mfolejewski/MirkoPC/readme.txt

Modular Integrated Raspberry Pi Computer
Yet another carrier board for Raspberry Pi Compute Module 4
