mfolejewski/MirkoPC/3D_ENCLOSURE/readme.txt

dedicated 3D printed case for MirkoPC REV1.1
