mfolejewski/MirkoPC/drawings/MirkoPC_bot_user.png

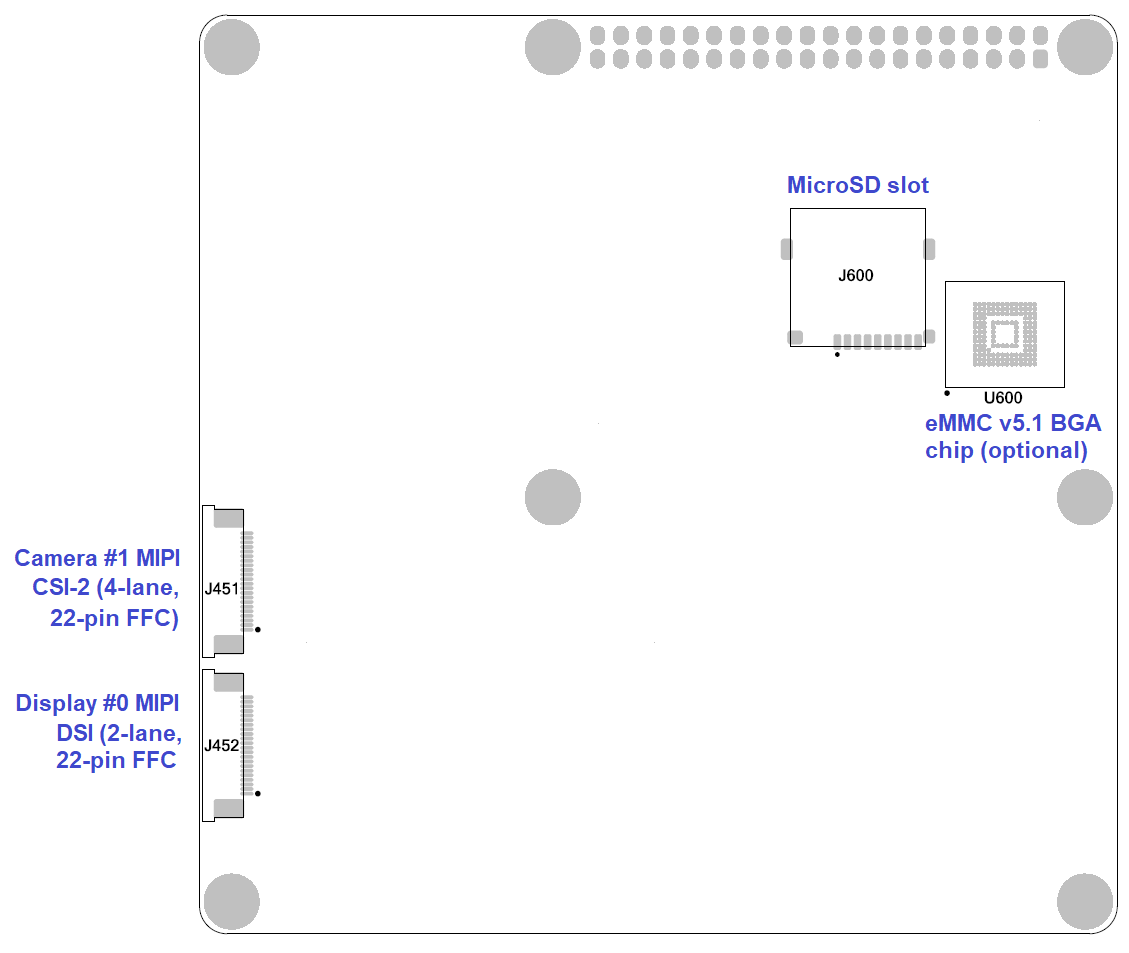
drawings/MirkoPC_bot_user.png
