mfolejewski/MirkoPC/drawings/MirkoPC_mechanical_drawing.png

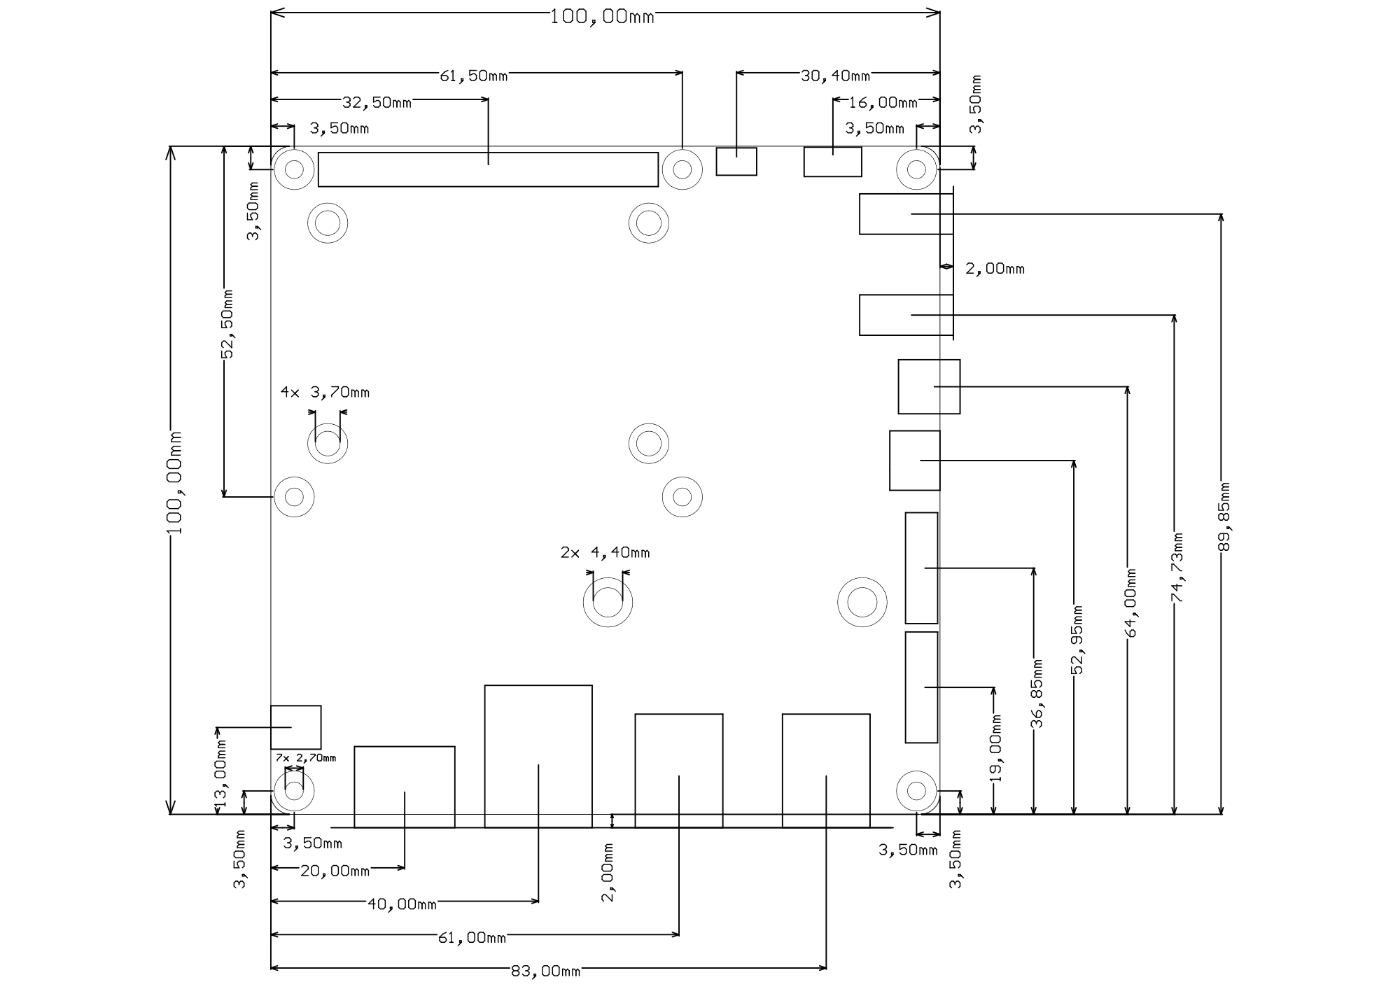
drawings/MirkoPC_mechanical_drawing.png
