mfolejewski/MirkoPC/drawings/MirkoPC_top_user.png

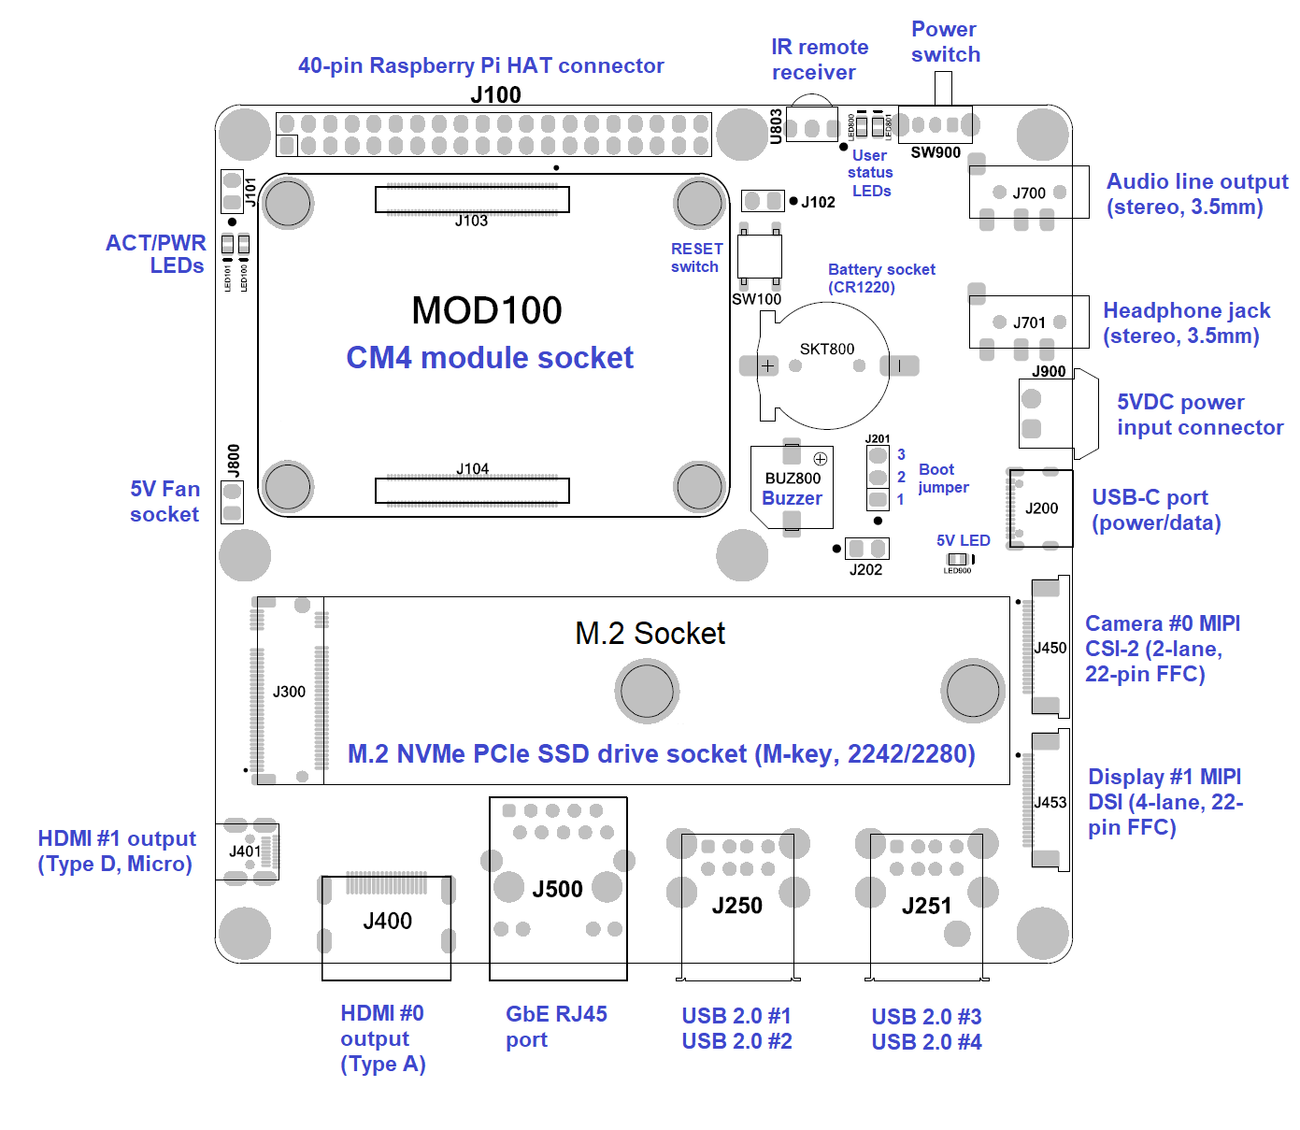
drawings/MirkoPC_top_user.png
