mfolejewski/MirkoPC/drawings/MirkoPC_bot_component.png

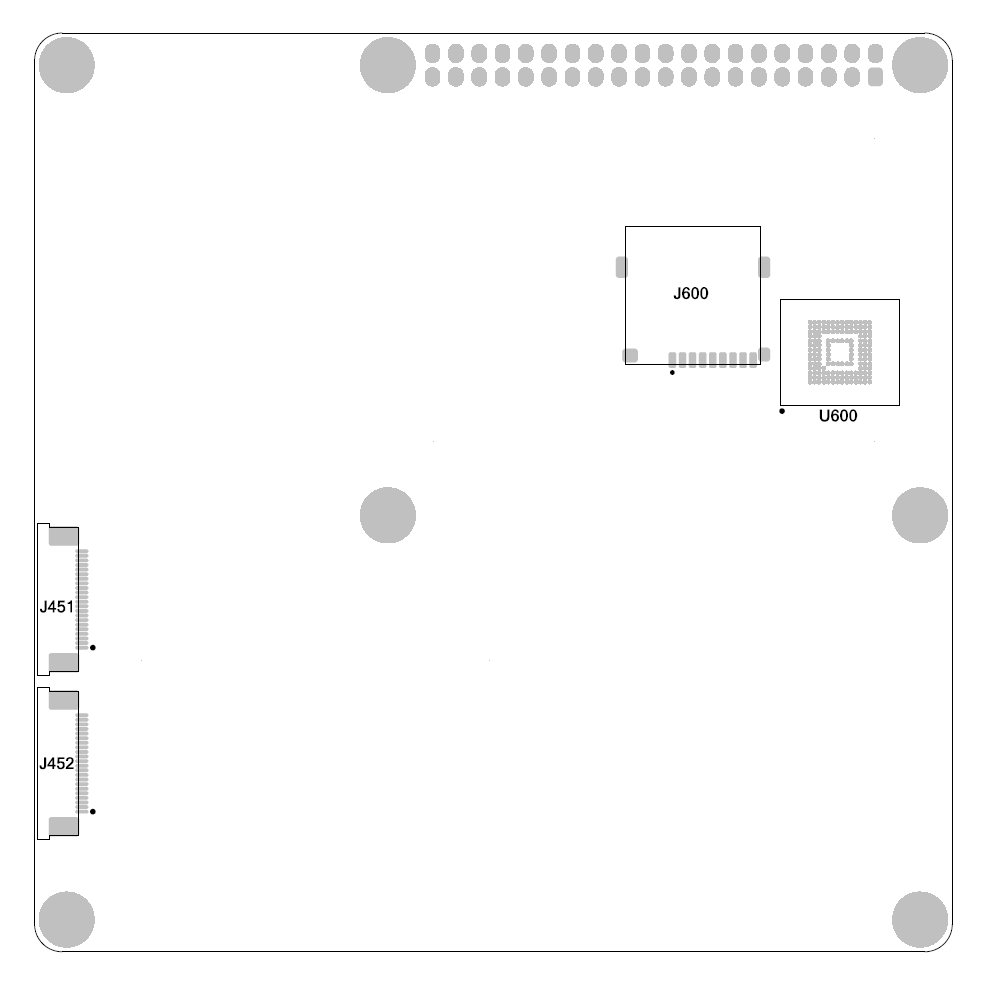
drawings/MirkoPC_bot_component.png
