mfolejewski/MirkoPC/drawings/MirkoPC_top_component.png

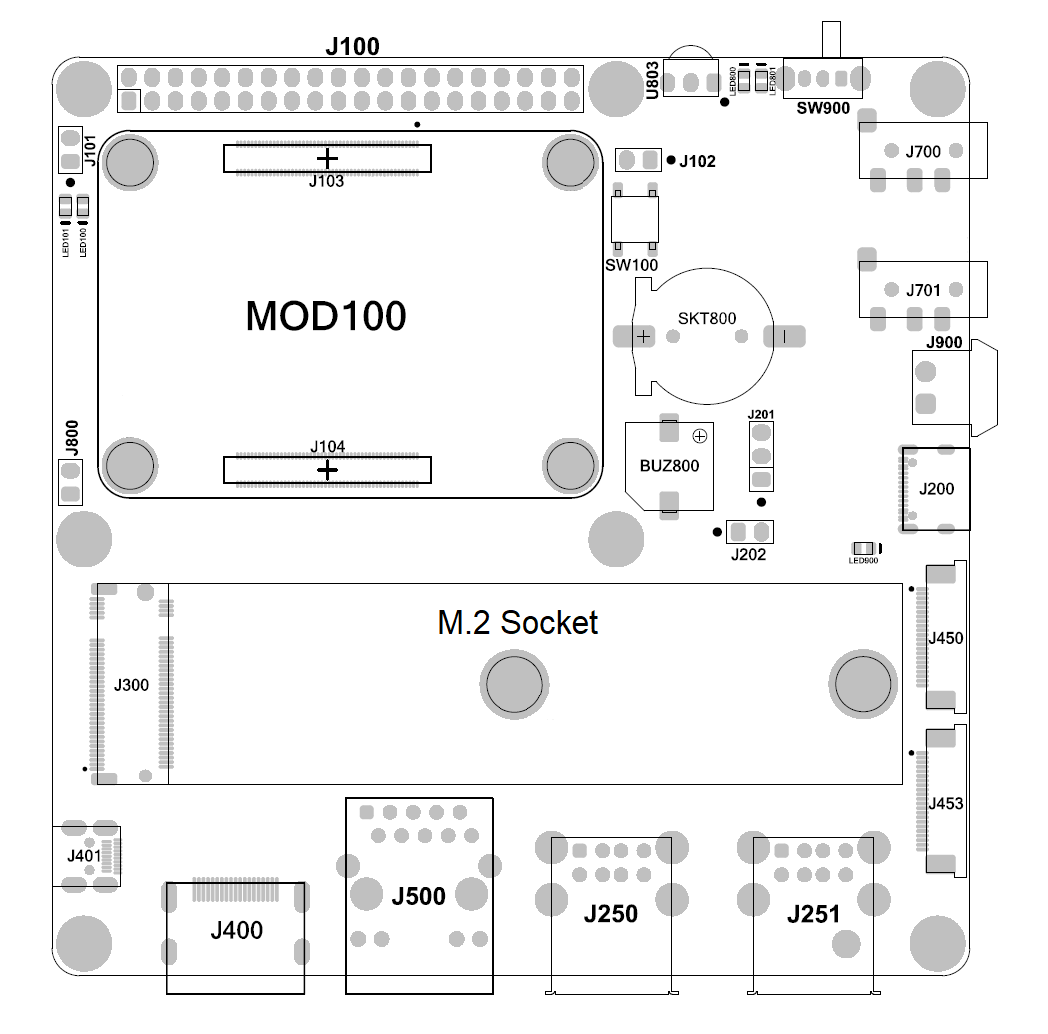
drawings/MirkoPC_top_component.png
