mfolejewski/MirkoPC/3D_ENCLOSURE/MirkoPC REV1.1 3D CASE (BOT).STL

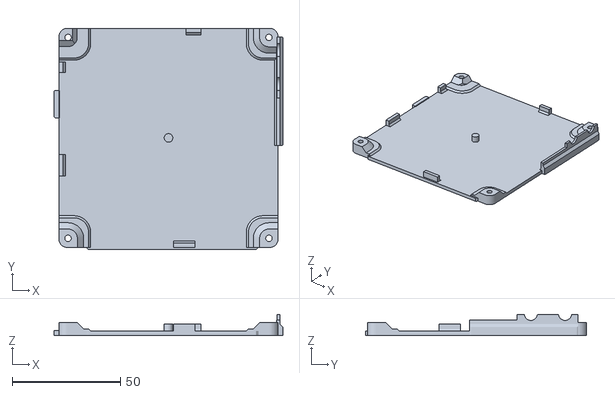
[picture p6: CAD file, 2021-11-18]
3D_ENCLOSURE/MirkoPC REV1.1 3D CASE (BOT).STL
106.0 x 102.5 x 9.75
