mfolejewski/MirkoPC/MirkoPC_REV1_Mechanical_dimensions_20210407.DXF

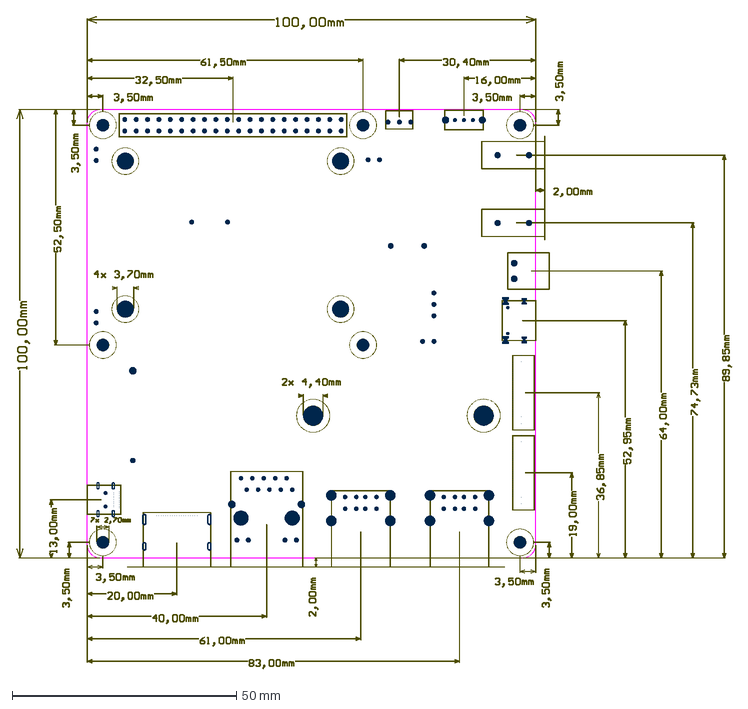
[picture p7: CAD file, 2021-04-07]
MirkoPC_REV1_Mechanical_dimensions_20210407.DXF
159.4 x 145.4 mm
