mfolejewski/MirkoPC/3D_ENCLOSURE/MirkoPC REV1.1 3D CASE (TOP).STL

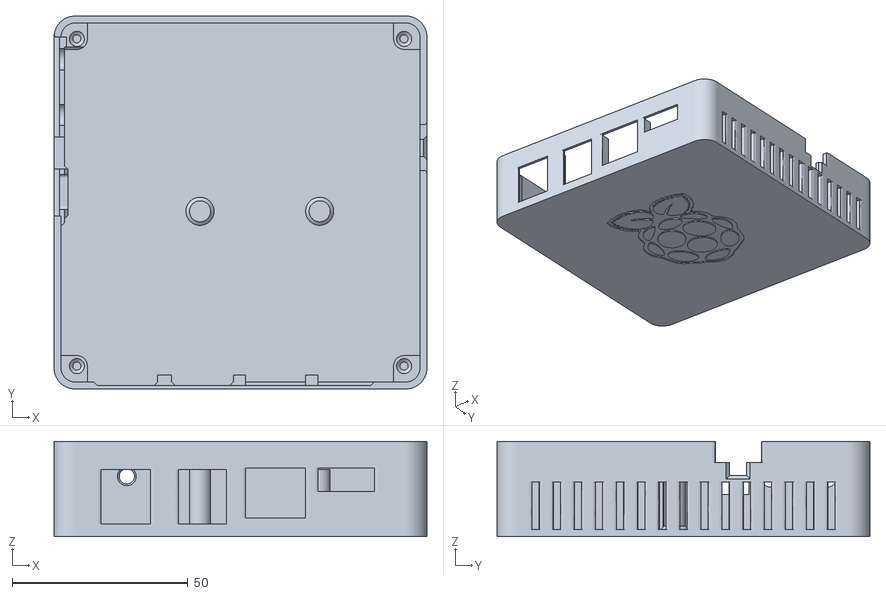
[picture p8: CAD file, 2021-11-18]
3D_ENCLOSURE/MirkoPC REV1.1 3D CASE (TOP).STL
106.0 x 106.0 x 27.0
