mfolejewski/MirkoPC/MirkoPC_V1_dimensions_2021-03-16.dxf

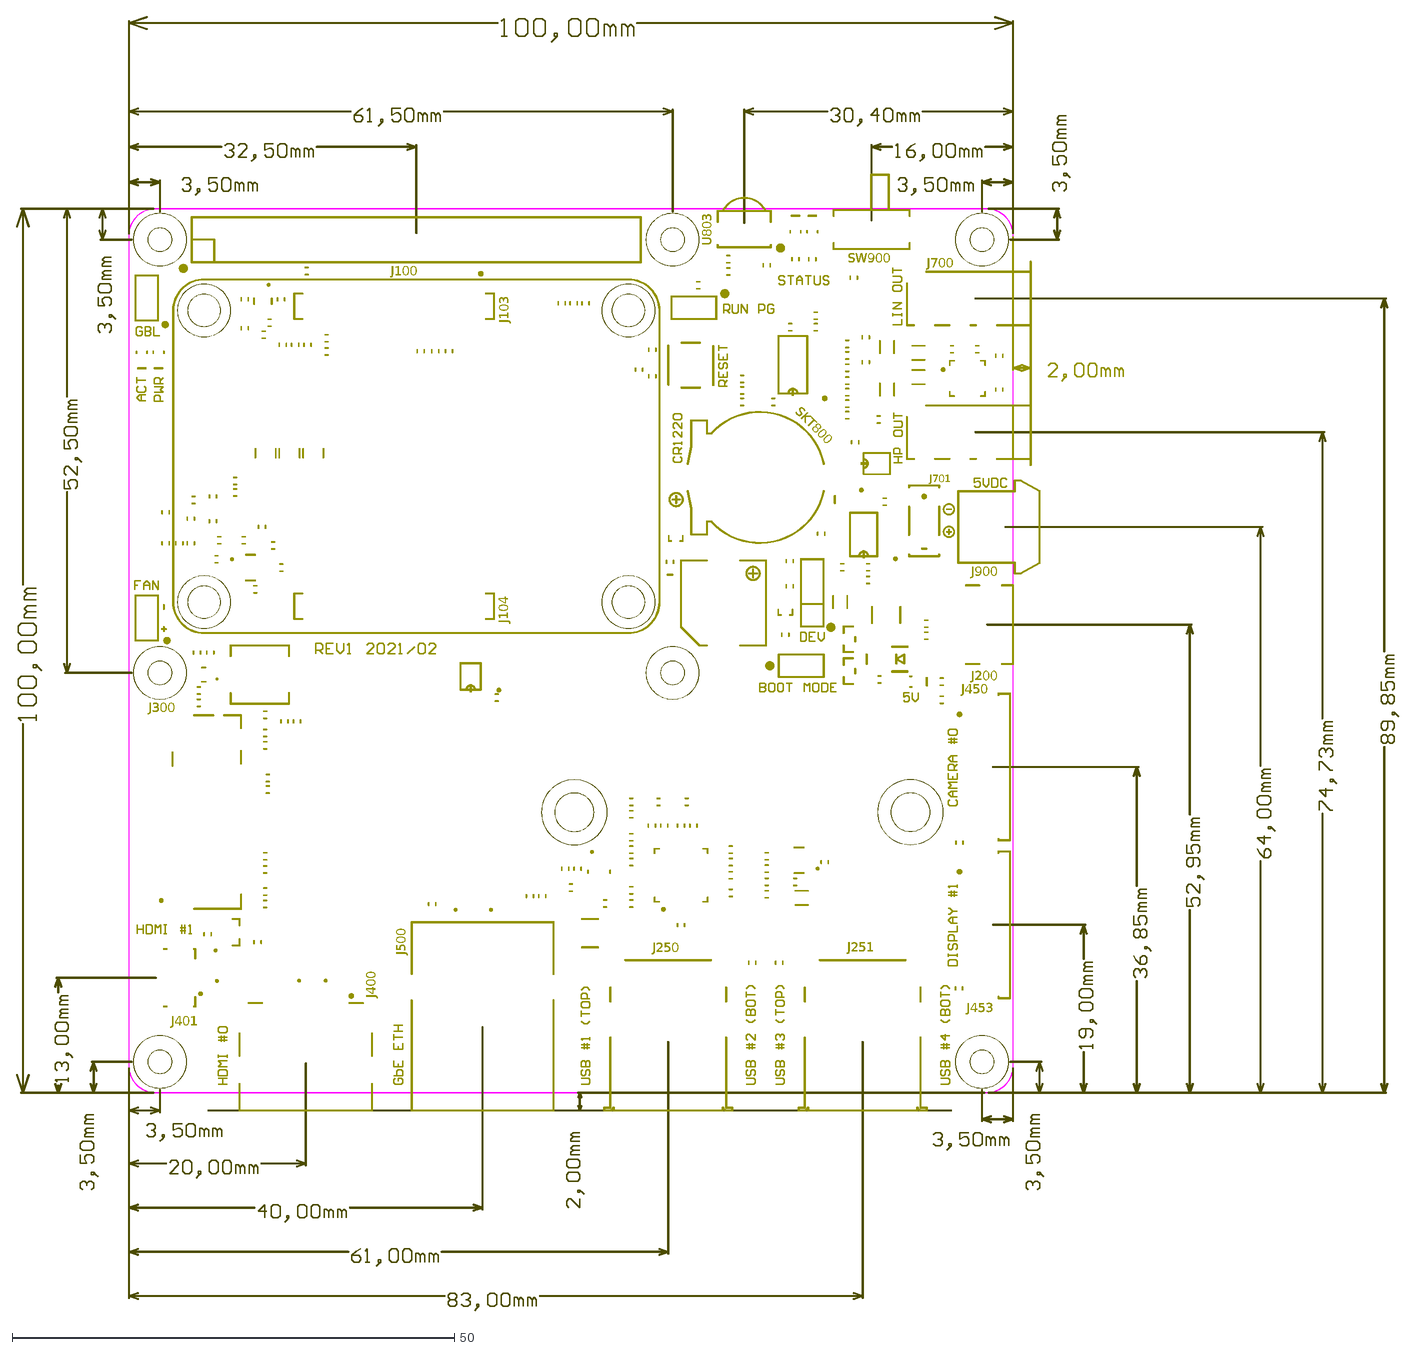
[picture p9: CAD file, 2021-03-16]
MirkoPC_V1_dimensions_2021-03-16.dxf
J701
J700
J104
J103
J100
J200
SW900
SKT800
U803
J453
J450
J400
J401
J300
J500
J250
J251
J900
