mfolejewski/MirkoPC/RPI_MiniPC_V1R1_Beta_Dimensions_20210206.DXF

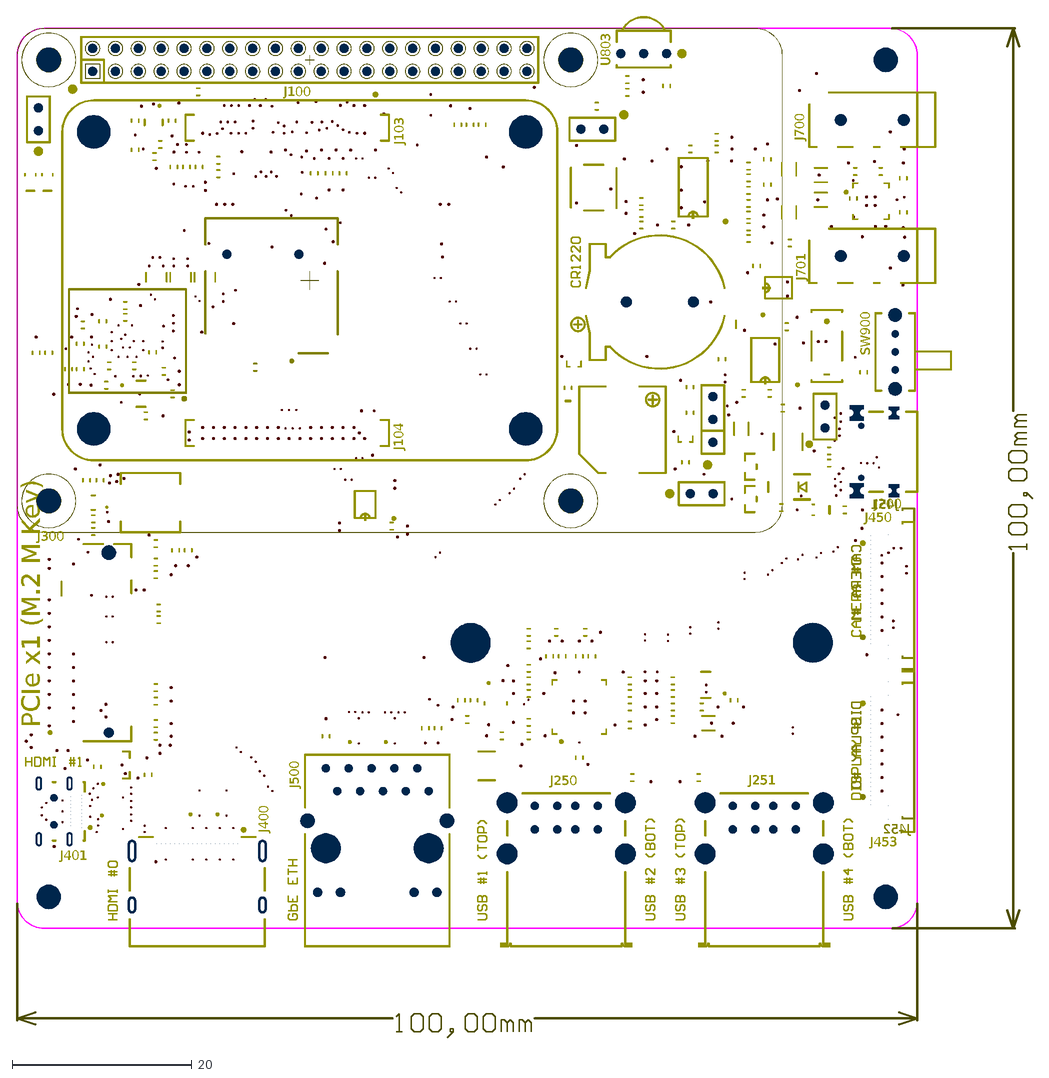
[picture p10: CAD file, 2021-02-06]
RPI_MiniPC_V1R1_Beta_Dimensions_20210206.DXF
PCIe x1 (M.2 M Key)
J701
J700
J104
J103
J100
J200
SW900
U803
J453
J452
J451
J450
J400
J401
J300
J500
J250
J251
