mfolejewski/MirkoPC/user_manual/readme.txt

Official user manual (datasheet) for MirkoPC users
