mfolejewski/MirkoPC/(threads)

Thread 1 (2021-04-07):

Publish news & updates here?

mi-hol, 2021-04-07:
The are folks that don't use Twitter/Facebook/... for good reasons.
Would it be feasible to publish news & updates in the future here too?

mfolejewski, 2021-04-07:
to tell you the truth, I don't know how to post updates on github, I use it very rarely .
So far, I'm using only Twitter or hackaday.io to publish project update.

mi-hol, 2021-04-13:
I noticed that updates via twitter had not been made on hackaday.io

hackaday.io would be a great source for the community.

Many project use github as the master for every communication, because it allows for simple migration of content to new distribution channels.
examples:
[](https://github.com/geerlingguy/raspberry-pi-pcie-devices/issues/112)

mfolejewski, 2021-04-14:
Yes you have right, on hackaday.io there is less data.
For me is easiest to create new post on Twitter (much faster).

Is really hard to publish news by using 3 different channels (github, hackaday and Twitter), due to I'm not full time maker as Jeff (sorry about that, but I don't have not enough time in my free time).

I'm using github to publish only the technical files.

Soon this project will be closed and I will switch to the next (I hope).

Thread 2 (2021-04-10):

MirkoPC_V1_3D_model_2021-03-16.pdf damaged/wrong content?

TMillesich, 2021-04-10:
The file:
MirkoPC_V1_3D_model_2021-03-16.pdf 11MB

shows only a white rectangle.
Even at 1000% no further details visible.

PDF Informations:
Paper Dimension: 2,97 x 2,09 cm

mfolejewski, 2021-04-11:
Github issue.
Please download this file and use Adobe Acrobat to open it.

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

mfolejewski, 2021-04-14:
I checked the PDF file on the github, is OK.
If you have an issue opening this file -> just download this PDF file and use free Adobe Acrobat Viewer.
Another option - please download the STEP 3D file and use any 3D CAD tool, e.g. FreeCAD, Inventor, Fusion 360.

Closed 2021-04-14.

Thread 3 (2021-04-18):

plase  think about 802.3at ;)

lsochanowski, 2021-04-18:
it will resolve 15W power problem and it will be best board in the world ;)

mfolejewski, 2021-04-20:
Thanks!

1. "15W issue"
OK, I need to clarify "15W issue". I added the 3A polymer fuse, to limit the input power due to USB-C spec. Unfortunately, it turned out that this fuse has too high series resistance and during operation it causes voltage drops on the 5V bus, approx. 0.1V, which causes irritating messages. My fault. Apart from the voltage drop, nothing bad is happening. The CM4 has its own PMIC which generates 3.3V and 1.8V voltages for the CPU, eMMC and RAM. The M.2 slot has its own 3A buck regulator. The rest of the hardware is powered by 3.3V from the PMIC CM4. Only the USB ports are powered from the 5V bus - however, the voltage drop to 4.8V has no negative consequences. The USB electronics have their own LDO or converters anyway, so apart from the annoying message, nothing bad is happening. I tested NVMe + CPU @ 2.2GHz, it worked stably.
I bridged the fuse in all other boards.
In REV1.1, the fuse will be removed because it causes more problems than benefits.
Unfortunately, powering electronics from 5V causes some problems, but it also has many advantages -> you can power the board from the USB-C port, mobile chargers or original RPi power supplies. As simple DIY project 5V rail is quite OK.

2. NVMe power consumption
Another thing - the power consumption of the NVMe disk. Since CM4 has only x1 lane and only GEN2, therefore drives specified even as 3V3 @ 3A will not consume such current (probably somewhere 50% less), due to the low PCIe bandwidth of approx. Max. 360MB / s (approx. 8-10x less than the max. throughput of NVMe disks - I'm guessing).

3. PoE support
I thought about adding the PoE option, but it would involve replacing the RJ45 connector with a more expensive one (I don't know if the footprint will be compatible) and there may also be a problem with adding the connectors (possible collision with the M.2 card).

Unfortunately, since the RJ45 connector is in a different location than on the RPi 4B, the PoE option would not be compatible with the original HATs.

The only chance is to add a 4-pin connector pointing down the board, but this would also require the design of a dedicated PoE + power supply, then it makes sense to design an industrial 12 / 24V power supply.

Initially, I had a plan to expand the project (hence the name: Modular Integrated Computer) and add at least 3 boards:
- IOB (input / outputs, analog / digital),
- GSB (GbE switch, 4xRJ45, 1 / 2x SFP sockets),
- IOT (RF - GSM / GNSS / LoRa / etc.),
- PSU (dedicated industrial power supply, 9-36V, 18-72V) + PoE option,
Unfortunately, such a project would require a lot of $$$ (serious investor required). This is an DIY project for now.

Anyway, I will consider the option of adding PoE and outputting the 5V / 3.3V system bus -> just in case and for future use -> but only for the REV2 (now I'm working on the REV1.1 to fix all the minor issues).

Thread 4 (2021-04-20):

co jest potrzebne

ojej, 2021-04-20:
Myśle, że to jest szansa na zrobienie sprzętu, którego nie ma.
Komputery maja problemy z zasilaniem. Nie ma komputera dla ludzi, którzy wola terminal, ale chca by sprzęt działał tydzien na jednym ładowaniu lub miesiąc. Nie musi być szybki ale zasilanie jest kluczem.
Trend jest taki, że wiele osób chce wrecz komputer do pisania jak zx88 https://en.wikipedia.org/wiki/Cambridge_Z88 albo https://www.clockworkpi.com/devterm albo https://hackaday.io/project/9692-ello-2m

Coś co ma normalny system ale jednocześnie jest mobilne. Nie działa przez 2 godziny, ale jest na prawde mobilne. jak psion 5 https://jm.iq.pl/psion-5mx-z-linuxem-na-pokladzie/ który działa tydzien na 2 paluszkach (choc ma 16Mhz zegar). Kluczem jest zasilanie i wygodna klawiatura. (choćby taka https://klawiatura.wordpress.com/wersja-mini/ tzw. czekolada gdzie masz 2 rodzaje klawiszy ułozonych normalnie a nie jak w mechanicznych klawiaturach)

Każdy kto próbował pisac na klawiaturze choć trochę szybciej wie, że tekst komputerowy z ;"|}{<>., itd nie jest możliwe pisanie szybko na klawiaturze laptopowej. Bo potrzebna jest normalna.

Zastanów się sam. Gdybyś miał mało prądu, był np. w podróży bez gniazdka, była wojna, to czy bys chciał komputer, którym możesz wysłac e-mail? Aby to zrobić malina nawet zero jest za duża. A jednocześnie jest niesamowicie wygodna. Ale nie dasz rodzinie sprzętu z mnóstwem kabli, z powerbankiem i powiesz, ze bedzie działać tylko 2 minuty. Dlatego warto stworzyć sprzęt niewielki, który można nosic ze sobą, ale który jest kompletny do małych zastosowań. Zasilanie jest głównym problemem. Którego wiekszość osób w ogóle nie bierze pod uwagę.

Panele słoneczne sa rewelacyjne, o ile ich nie musisz nosic i ne plącza się kable. Pisanie rysikiem nie jest złe gdy nie musisz pisac listu w slabym oswietleniu. Zatem klawiatura, solidna i wygodna, zasilanie i niewielki ekran jako awaryjne czytanie i pisanie. Wszystko zintegrowane (zapewne mechaniczne klawisze) w pojedyńczej obudowie. Bez zbędnego rozpraszania, bez komunikatorów, www itp.

Jeśli jestes programistą, pisarzem lub po prostu coś toworzysz a nie tracisz czas przy komputerze docenisz komputer, który nie rozładuje sie w ciągu jazdy pociągiem i wystarczy na tyle by napisac opowiadanie.

Pomyśl nad tym i zapytaj innych ludzi czy taki sprzet jest dla nich wazny. Czy nie czują się uwiązania do gniazdka, cywilizacji. Ja chciałbym cos małego co ma normalną klawiature jak ta na której piszę, terminal, ssh, mutt, gcc, ruby, python, mc, git. A jeśli trzeba wiecej po prostu przesiadam się na wiekszy monitor. Bo programowanie w każdych warunkach to coś o czym maży każdy https://liliputing.com/2021/02/lisperati1000-is-a-diy-portable-programming-workstation-with-a-mechanical-keyboard.html

0xtrzy, 2021-04-21:
Unix ma inna filozofię niz obecne myszo graficzne sposoby komunikacji. Ale jest bardzo szybki. Nadal programy w terminalu sa po prostu szybsze i wydajniejsze energetycznie.

Faktycznie czasem coś człowieka najdzie i chciałby poprawic kod w biegu. Pisanie na wirtualnej klawiaturze w komórce jest trudne. Gdyby powstał taki sprzęt z linuxem, freebsd czy z procesorem fpga obok soc z arm to było by to bardzo wygodne. Niestety ja nie znam się na elektronice.
Ale skoro sa maleńkie laptopy GPD to dlaczego nie zrobić sprzętu nastawionego na długi czas pracy. PixelQ ma chyba dobry wyświetlacz, który nie wymaga dużo prądu. Ale chyba nie chciałbym już wyświetlacza alfanumerycznego. Człowiek przyzwyczaił się do powerline i innych wynalazków konsoli z fonthack

mfolejewski, 2021-04-22:
@ojej
dzięki za komentarz i przemyślenia.

Kurcze no nie wiem. Prawdę mówiąc mam trochę odmienne zdanie. No nie wiem, czy większość ludzi potrzebuje maszyny do pisania. Większość podanych przykładów przez Ciebie przypomina mi PDA, palmtopy, pierwsze laptopy, pagery czy inne podobne wynalazki.
Przyznam, że nie wiem, kto potrzebuje komputera tylko do pisania i wysyłania emaila. Ludzie generalnie cenią sobie rozbudowane możliwości funkcjonalne, WiFi, internet, duży dysk, szybką przeglądarkę, oglądanie filmów, setki aplikacji, media społecznościowe, robienie zdjęć/filmów - dlatego uważam, że większość takich wynalazków zastąpił smartfon i nic tego nie zastąpi (chyba długo jeszcze). Do takich celów potrzeba mocnego procesora, zasobów, sporej pamięci.
Procesor 16MHz tego nie uciągnie, nawet podkręcowy RP2040 do 400MHz będzie miał wydajność wystarczającą do prostych aplikacji testowych i graficznych.
Może się mylę, ale zasilanie nie jest już takim dużym problemem, praktycznie wszędzie można podładować telefon albo zabrać power bank.

Myślę, że fajnym wynalazkiem byłaby stacja dokująca do smartfona, gdzie podłączasz klawiaturę, myszkę, monitor i możesz korzystać jak z komputera stacjonalnego.
Albo np. stacja dokująca w formie laptopa -> wkładasz smarfona i masz laptopa.
Parę lat temu miał taki patent Asus - ASUS PadFone
https://komorkomania.pl/37897,asus-padfone-czyli-smartfon-tablet-i-notebook-w-jednym-podroz-w-czasie
Ale chyba się nie przyjęło. Tak jak z PDA Apple Newton - też się nie przyjęło, choć ta koncepcja przypomina mi protoplastę smartfona.

Parę lat temu widziałem chyba u Samsunga (Samsung DeX) i LG stacje dokujące do smartfona, które zamieniają telefon w PC-ta.
Chyba nawet tam był jakiś inny OS, albo zmodyfikowany Android.
Ale to też się nie przyjęło.

Pytanie czy to ma być projekt amatorski, czy produkt komercyjny (elektronika konsumencka).

No a nie da się normalnie podłączyć klawiatury na USB czy BT do smartfona? To nie będzie to samo? Ekran 6-7" nie jest tragiczny, jeśli się ma poprawić coś w biegu. No chyba, że użyje się tableta z klawiaturą. Ale tu i tak mamy już laptopa, nieważne czy z odpinaną klawiaturą czy nie (takich hybryd jest pełno).

Nie jestem programistą, więc ciężko mi ocenić jak duży jest to problem, edycja kodu mobilnie (np. w pociągu).
Mały laptop 12" chyba nie jest taki zły? Nie wiem, nie znam się nie wypowiadam.

Generalnie z tym jednym projektem to jest masa roboty. Nie chcę myśleć o kolejnych, bo chcę skończyć, to co zacząłem.
Mam w sumie kilka innych pomysłów (niektóre odjechane), ale raczej nie chcę się dzielić tym na forum (wiadomo chińczycy też potrafią czytać).
Na bazie tego komputerka można wykonać kilka ciekawych modyfikacji - na pewno jedną - dla maklontentów z Wykop.pl czyli wszystkie złącza na jednej krawędzi i płytka ~20cm długa (jamnik albo RPi 400) :-) Kwestia formy.
Projekt można modyfikować, dodawać inne gadżety - GSM, GPS, itp, itd. Robić jakieś sterowniki dla automatyki, przemysłu. Z drugiej strony - nie ma to komputerków na Malince? Jest przecież Revolution Pi czy kilka innych. Konkurencją i tak nie będę dla większej firmy technologicznej. Warto szukać nisz. Może fotowoltaika, kryptowaluty, IoT, ML/AI, czy Industry 4.0. To co aktualnie jest na czasie.

Jedyne, czym obecnie jestem rozczarowany to Google Coral TPU M.2 na PCIe -> niestety jest jakiś problem z adresowaniem 64-bit na PCIe dla CM4 (MSI-X) i na razie wydaje się problem być nierozwiązany. Pozostaje wersja póki co na USB.
A szkoda, bo Machine Learning na Malinie, obraz z kamery lub dwóch i można robić ciekawe rzeczy. AI.
Choć podobno Edge Impulse też ma jakieś rozwiązanie dla RPI + ML.

OK, koniec rozważań, bo muszę wracać do roboty, sama się nie zrobi :-)

ojej, 2021-04-22:
>Większość podanych przykładów przez Ciebie przypomina mi PDA, palmtopy, pierwsze laptopy,
>pagery czy inne podobne wynalazki.

Właściwie żaden nie jest to pda. Myślę o klawiaturze jako czyms co jest najistotniejsze do pisania, tak listów, jak i programów jak i książek. Zastanawiam się jak to ująć i może podam przykłady. Jest dużo edytorów, które nie maja nic aby nie przeszkadzało w pisaniu. https://hemingwayapp.com/desktop.html Albo maszyn
https://www.kickstarter.com/projects/astrohaus/hemingwrite-a-distraction-free-digital-typewriter

Co do reszty to właśnie na wszystko podałem przykłady. Wiekszosc laptopów nie mówiąc o komórkach nie ma pg up. nie ma home, nie ma też wielu innych rzeczy. Mówisz, że masz gniazdko i zawsze prąd ;) zapisz sobie to zdanie będziesz mógł sie pośmiać z siebie.
A zrobienie oszczędnego komputera, który by dzialał na prawde długo to jest sztuka i na razie mało komu sie udała. RP2040 to chyba najbardziej energochłonne rozwiązanie. Ale nawet fundacja rpi ma komputer z klawiaturą. Czyli wracamy do punktu wyjścia, że jest to cos cennego. Ale nie ma klawiszy mechanicznych itp.

Wiele osób robi modyfikacje klawiatur, które kosztują 300-800zł i schodzą jak ciepłe bułeczki. I chinczycy ciagle nie robią programowalnych klawiatur. Poszukaj, najwyżej nakładki na klawisze lub obudowe. Jedyne co możesz zrobic to samodzoielnie polutowac wlasna klawiaturę lub kupić za 500zł egzemplarz który niewiele oferuje po za sama klawiaturą. Nie podłączysz tam nawet https://www.crowdsupply.com/quicklogic/qomu

To całe pisanie to oczywiście tylko sugestia, ale sugestia przemyślana osoby, która dużo pisze i wie co to terminal.

co do modyfikacji tego projektu to sam bym dodał dużo więcej niż marudzenie na wykopie. np. to co kiedys mial każdy komputer, kluczyk jak w stacyjce do uruchamiania i wyłączania. Może z lepszym kluczem by nie dało się łatwo go obejść. To samo z przeniesieniem informacji z desktopu na obudowę. No i warto było by ustawić po prostu kilka płyt pionowo by było lepsze chłodzenie i wydajnośc. Wiele osób szuka klastra. Nawet słabej wydajności bo klaster sie inaczej programuje. Inaczej skaluje i nawet słabe procesory potrafią unieśc ogromne strony www co możesz zobaczyc w pine64 www/matrix/mastodon itp.

mikolaj24, 2021-05-01:
Komputer w klawiaturze to pomysł starszy niz laptop. Może dlatego ciągle jest taki popularny.
Ale klawiatura musiała by być mechaniczna. Nienawidze tych wszystkich kabelków, gdyby można było je ograniczyc do zasilania było by super.

Thread 5 (2021-04-27):

DRC

conkerkh, 2021-04-27:
Czesc, moglbys w miare mozliwosci dodac info o minimum wymaganym do produkcji PCB? Czy w standardowym 4 warstwowym JLCPCB da rade to zrobic? (min srednica przelotek, szerokosc sciezek itd), niby mozna zaladowac gerbery i ale nie zawsze to dobrze dziala. Warto w readme dac takie info.

P.S. Super projekt :D

mfolejewski, 2021-04-30:
Specyfikacja techniczna projektu PCB odnośnie produkcji wygląda tak:

- płytka 4-warstwowa, laminat 1.6mm, folia 25um (1oz),
- kontrola impedancji: stackup JLC2313,
- soldermaska zielona, silkscreen dwustronny.
- track/gap: 4 mil (0.1mm),
- vias min: 0.25 / 0.55 mm (annular ring -> 0.15mm).
- tg standard.

Projekt ze względu na ograniczony budżet, był produkowany w JLCPCB na standardowym profilu 4-warstowym, ale z wybranym stackupem JLC2313 (wymagana kontrola impedancji).

U mnie ładowanie plików GERBER do JLC działa praktycznie zawsze bez błędów (generuję owierty do osobnych plików, nie ma problemu z wykonaniem slotów, otworów NPTH, itp.).

mikolaj24, 2021-05-01:
daj jeszcze plik stl do drukarki 3d lub .... frezarki. W drewnie opakowanie było by ładne

ltenfield, 2023-11-01:
where are the Kicad or Gerber files to produce this board

Thread 6 (2021-08-04):

I've love to see MirkoPC with USB3 + 12V support

Lars-Malmgren, 2021-08-04:
USB3 support for fast data-transfer from astro cameras.
Also support of 12V supply would give more power to M.2 module + USB3 etc.

fanoush, 2021-09-06:
Well usb 3.0 together with native NVME means adding PCI-E switch chip to extend the single PCI-E line available - which adds a lot of complexity. OTOH I would trade more pci-e devices for that hi-fi audio in a heartbeat :-) Wonder if there is any other CM4 board with PCI-E switch and more pci-e slots builtin?

pepe2k, 2021-09-07:
> Well usb 3.0 together with native NVME means adding PCI-E switch chip to extend the single PCI-E line available - which adds a lot of complexity. OTOH I would trade more pci-e devices for that hi-fi audio in a heartbeat :-) Wonder if there is any other CM4 board with PCI-E switch and more pci-e slots builtin?

The problem is that currently RPi bootloader doesn't support booting from NVMe behind a PCIe switch.

fanoush, 2021-09-07:
> The problem is that currently RPi bootloader doesn't support booting from NVMe behind a PCIe switch.

Yes, they [may add it](https://www.raspberrypi.org/forums/viewtopic.php?p=1848378#p1848378) or they will not, at least they know about it and [fixed bugs related to presence of the switch](https://www.raspberrypi.org/forums/viewtopic.php?p=1838224#p1838224) so it is not completely broken and is sort of supported configuration to have the switch there. Workaround is to boot from /boot partition on something else.

I think anyone who would appreciate such board with multiple pci-e devices can workaround this issue (I have small 128MB microsd card with only the boot partition copy when booting from NVME behind switch on CM4 IO board, or it boots directly when I remove the switch from the setup)

fanoush, 2021-09-07:
And BTW with the hypothetical board having the switch and multiple pci-e/minipcie/m2 slots you may even want booting from pci-e to sata bridge (from sata SSD, not NVME) and that config won't be supported in bootloader either so booting from microsd or emmc is necessity in such advanced configurations anyway and still such board may make sense.

Another point may be limited bandwidth of 1x PCI-E 2.0 link. However when testing with the switch and nvme SSD + VIA usb 3.0 card with sata ssd in usb3.0 to sata adapter and reading both disks concurrently the bandwidth is nicely shared over the switch and when one is not in use the other gets full speed. So I can imagine you can have e.g. another gigabit ethernet or wifi card via pci-e and still use SSD over same link without issues. One can have e.g CM4 board acting as small home NAS and gigabit router with data on sata/nvme ssd (while even possibly booting mostly read only system like opewrt from microsd/emmc). So when using internal gigabit and internal wifi and second pci-e wifi for dual channel (both 2.4 and 5GHz) and second gigabit ethernet for routing, the single 500MB/s PCI-E link may not be such bottleneck for this setup.

pepe2k, 2021-09-08:
@fanoush
> And BTW with the hypothetical board having the switch and multiple pci-e/minipcie/m2 slots you may even want booting from pci-e to sata bridge (from sata SSD, not NVME) and that config won't be supported in bootloader either so booting from microsd or emmc is necessity in such advanced configurations anyway and still such board may make sense.

For me, booting from microSD or eMMC is unreliable and too risky, I usually avoid such configurations. I'm aware of 2 projects with embedded PCIe switch/es (one focused on Ethernet/WiFi and one for multi 4/5G), kept on-hold because of missing support for booting from NVMe behind a switch... and of course world-wide IC/components shortage.

Thread 7 (2021-10-19):

USB power

Julspower, 2021-10-19:
Hi
I did try your board for the first time today (finally)
programmed the emmc using windows 10 work great
connect a lcd
switch to OS, boot
I get to the raspberry os
connect my K400 unify dongle to usb
no keyboard or mouse
reboot with dongle connected no keyboard or mouse
plug a usb flash no led on the drive

it seem like my usb hub doesn't power the usb connector
is there something I have to do to enable it?

Julspower, 2021-10-19:
C250 has 4.89V
but pin 3 of U250 is at 0V
when the power is removed I mesure around 540ohm at C251 which might be U250 but im not sure

Julspower, 2021-10-19:
Pin 4 of U250 is at 2.8V seem this pin is left floating, its an open drain so U250 is not reporting fault
but I think this pin need a pullup (might be internal to the other end of that trace, I haven't checked)

mfolejewski, 2021-10-20:
> Hi I did try your board for the first time today (finally) programmed the emmc using windows 10 work great connect a lcd switch to OS, boot I get to the raspberry os connect my K400 unify dongle to usb no keyboard or mouse reboot with dongle connected no keyboard or mouse plug a usb flash no led on the drive
>
> it seem like my usb hub doesn't power the usb connector is there something I have to do to enable it?

This is the most popular CM4 issue with the USB interface:

See the CM4 datasheet:

The USB interface is disabled to save power by default on the CM4 . To enable it you need to add
dtoverlay=dwc2,dr_mode=host to the config.txt file

https://www.jeffgeerling.com/blog/2020/usb-20-ports-not-working-on-compute-module-4-check-your-overlays

Explanation:
https://github.com/raspberrypi/firmware/issues/1500

mfolejewski, 2021-10-20:
> C250 has 4.89V and 3.294V on C263 but pin 3 of U250 is at 0V when the power is removed I mesure around 540ohm at C251 which might be U250 but im not sure

Please configure the USB interface at 'config.txt' file:
dtoverlay=dwc2,dr_mode=host

Closed 2021-10-20.

Thread 8 (2021-12-08):

I've love to see MirkoPC with CAN-FD with MCP2518FD

uControllerLab, 2021-12-08:
I've love to see MirkoPC with CAN-FD with MCP2518FD to have very low latency for real time communication with other cheap board like stm32f103 Bluepill or Espressif ESP32 over standard CAN.
MCP2518fd suport CAN and CAN-FD and is very cheap but very very good with raspberry pi.
So a very cheap upgrade we get a very large number of upgrades for automation in the automotive industry and home automation projects.
Please consider this suggestion !!!

Thread 9 (2022-07-19):

So where can i buy this ?

guy111a, 2022-07-19:
Looks amazing!

mfolejewski, 2022-10-04:
thanks!,
so far I stopped project from few reasons:
- chip shortage: I can't buy components such as fan controller (EMC2301), PMIC controller (Attiny4), USB hub (USB2514), and 3.3V buck regulator (AP3441).
- project require update and some modifications, such as better EC/PMU controller with dedicated Linux application (system info/monitor), cheaper USB hub, etc.
- lack of money for ordering next batch.
- not enough time to continue this project (I'm full-time employee, I'm involved also in few other DIY and commercial projects).

Thread 12 (2023-01-23):

Nano ITX?

samuk, 2023-01-23:
I was wondering if you'd considered making the board 2cm wider and moving a through-hole to make the board into a Nano ITX-compliant standard like the [Beaglebone AI-64?](https://beagleboard.org/ai-64) , [Pi-gear Nano](https://www.uugear.com/product/pigear-nano/) or [Jeston Xavier Nano ITX ](https://www.aetina.com/wp-content/uploads/Datasheet/Aetina_AN810_XNX_datasheet.pdf) there are some robotics use cases where you might want to stack some different [compute modules](https://www.amazon.co.uk/nano-itx/s?k=nano+itx&page=2&qid=1674469454&ref=sr_pg_2)

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

Closed 2023-01-31.
