mfolejewski/MirkoPC/MiniPC_V1R1_Schematic_20210317.pdf

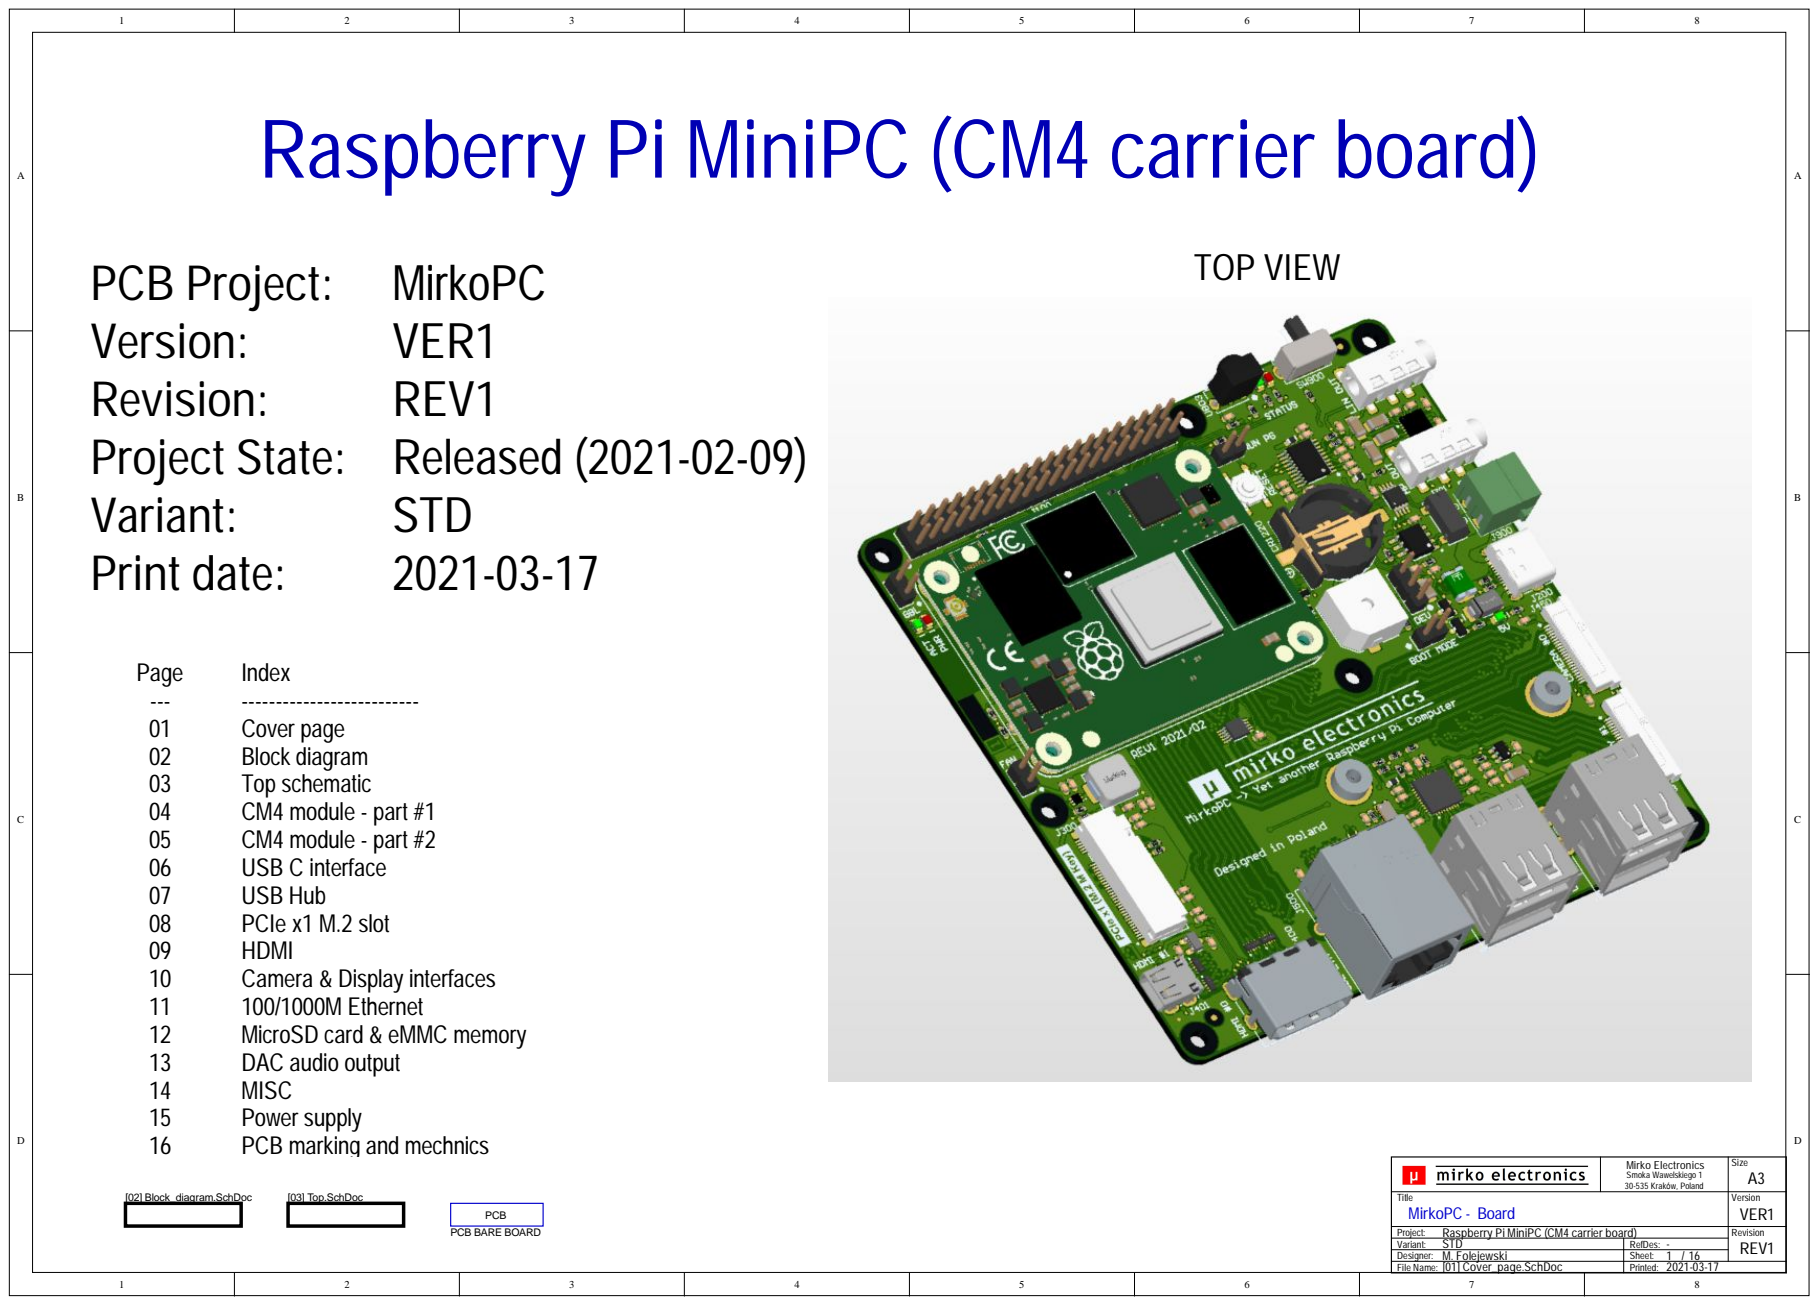
[picture p63: page 1]

Index
Cover page
Block diagram
Top schematic
CM4 module - part #1
CM4 module - part #2
USB C interface
USB Hub
PCIe x1 M.2 slot
HDMI
Camera & Display interfaces
100/1000M Ethernet
MicroSD card & eMMC memory
DAC audio output
MISC
Power supply
PCB marking and mechnics

Mirko Electronics Smoka Wawelskiego 1 30-535 Kraków, Poland | Size A3

Title MirkoPC - Board | | Version VER1

Revision REV1
Variant: STD
Designer: M. Folejewski
File Name: [01] Cover_page.SchDoc | Printed:

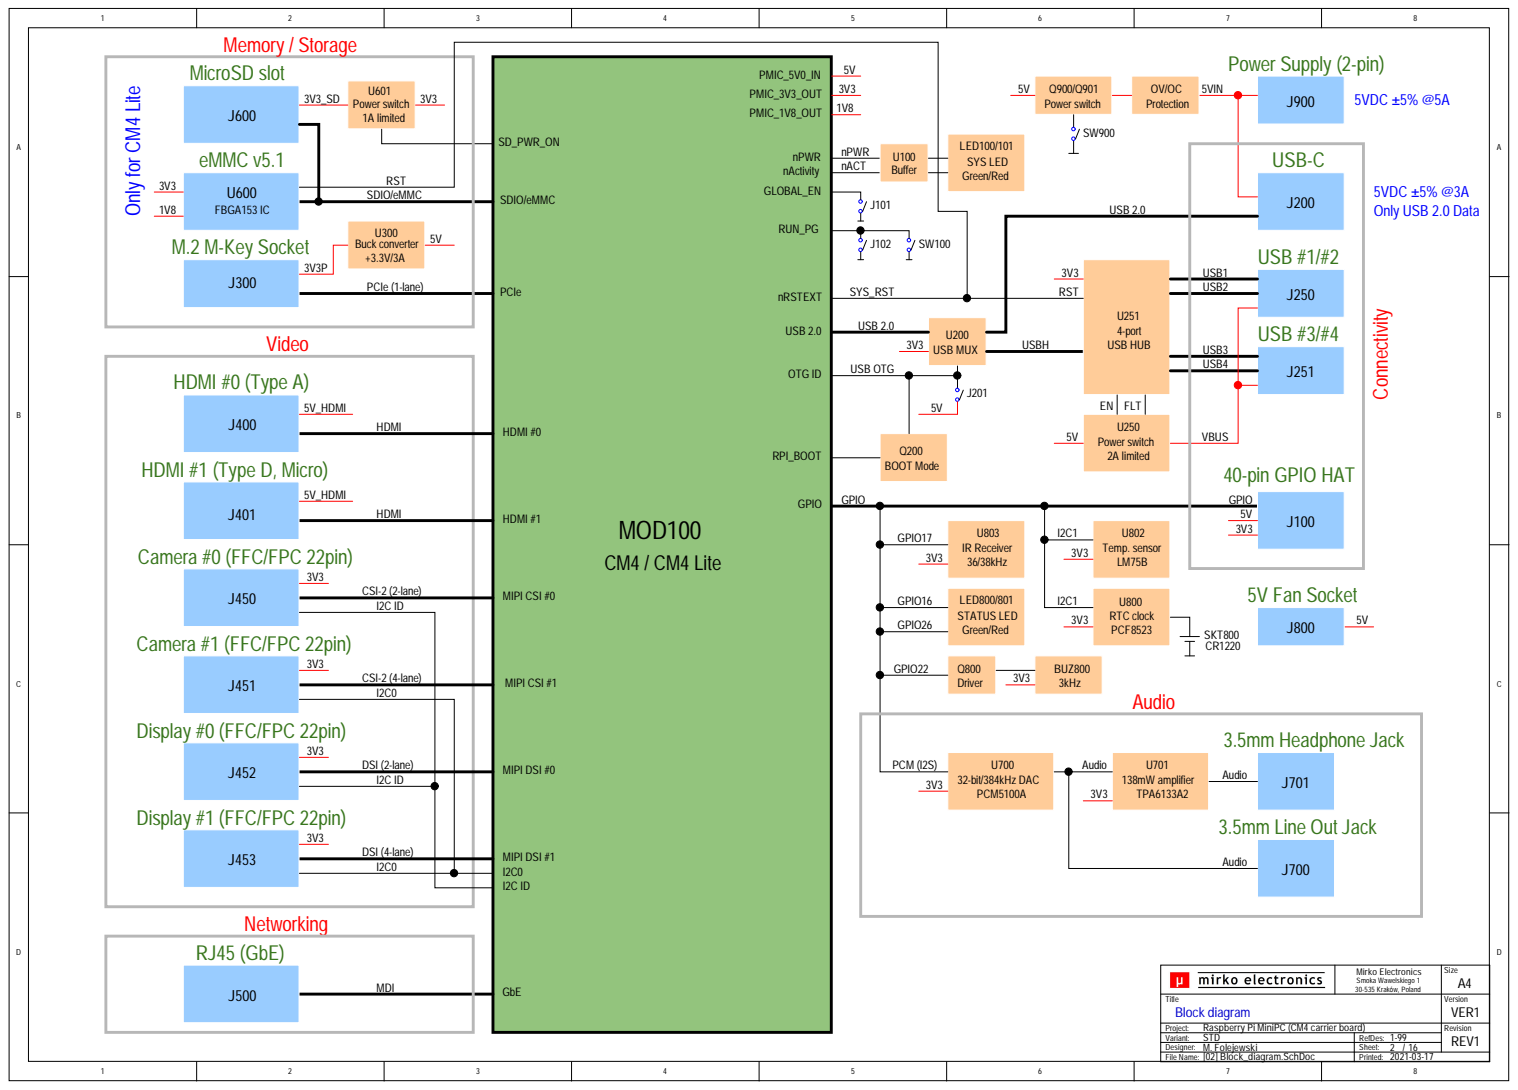
[picture p64: page 2]

RST
SDIO/eMMC

USB OTG OTG ID

MIPI CSI #0 CSI-2 (2-lane) J450

3V3 | MIPI CSI #1 CSI-2 (4-lane) J451

3V3 | MIPI DSI #0 DSI (2-lane) J452

MIPI DSI #1 DSI (4-lane) J453

Mirko Electronics Smoka Wawelskiego 1 30-535 Kraków, Poland | Size A4

Title Block diagram | | Version VER1

Revision REV1
Variant: STD

File Name: [02] Block_diagram.SchDoc | Printed:

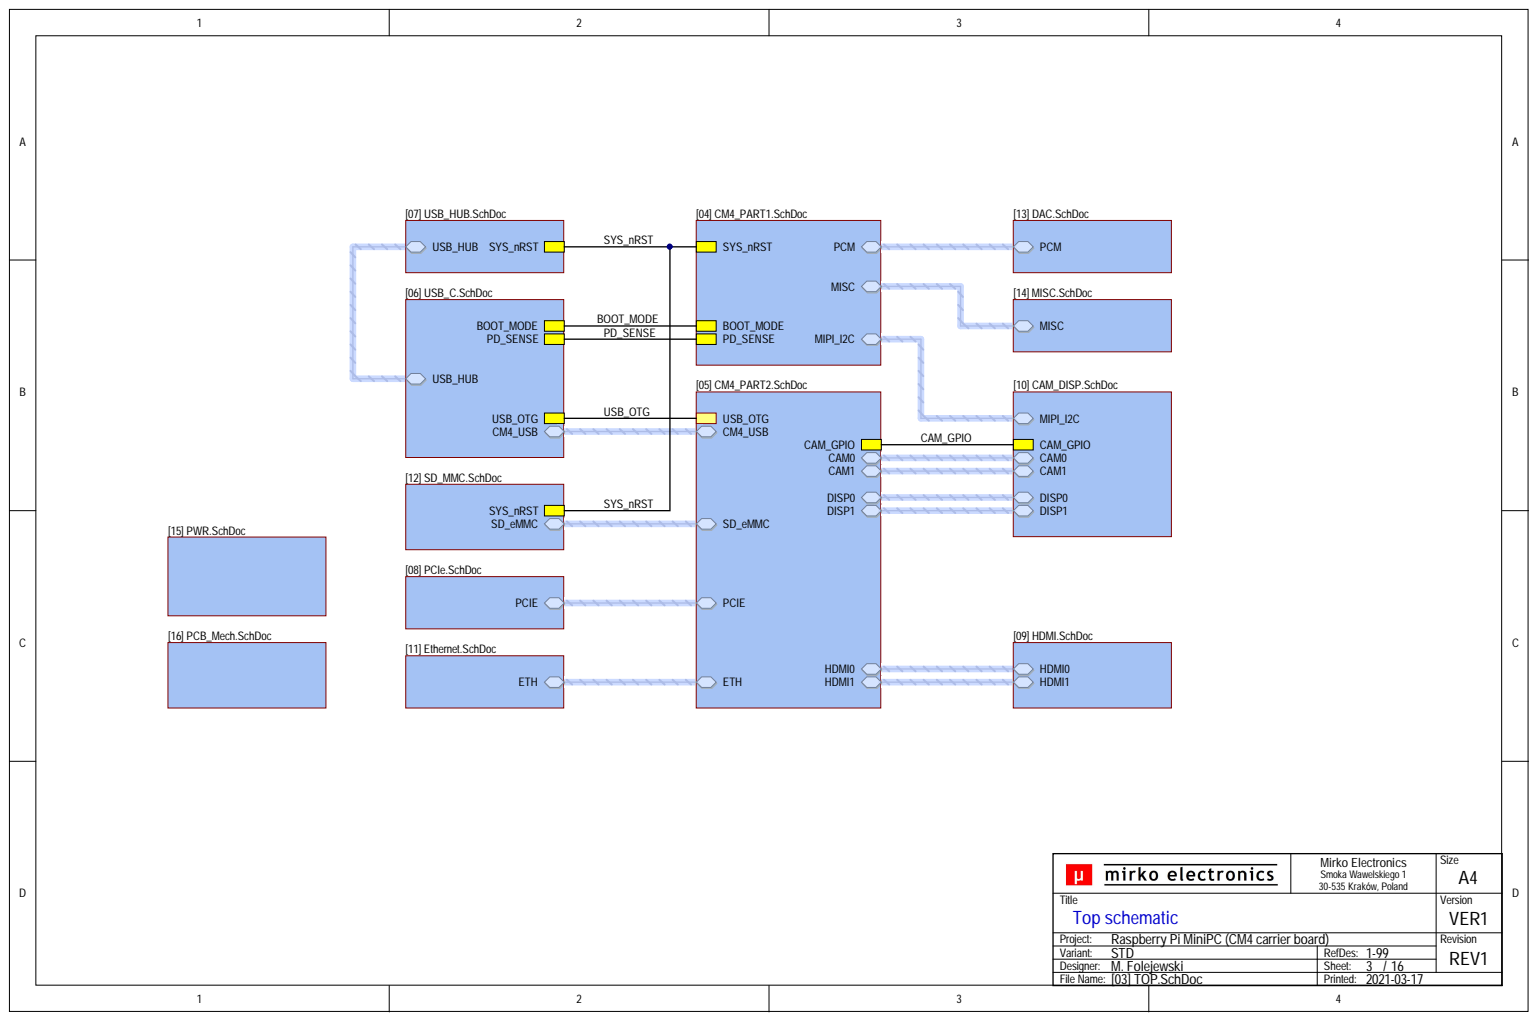
[picture p65: page 3]

BOOT_MODE
PD_SENSE

Mirko Electronics Smoka Wawelskiego 1 30-535 Kraków, Poland | Size A4

Title Top schematic | | Version VER1

Project: Raspberry Pi MiniPC (CM4 carrier board) | | Revision REV1
Variant: STD | RefDes: 1-99

Sheet: 3 16 /

File Name: [03] TOP.SchDoc | Printed: 2021-03-17

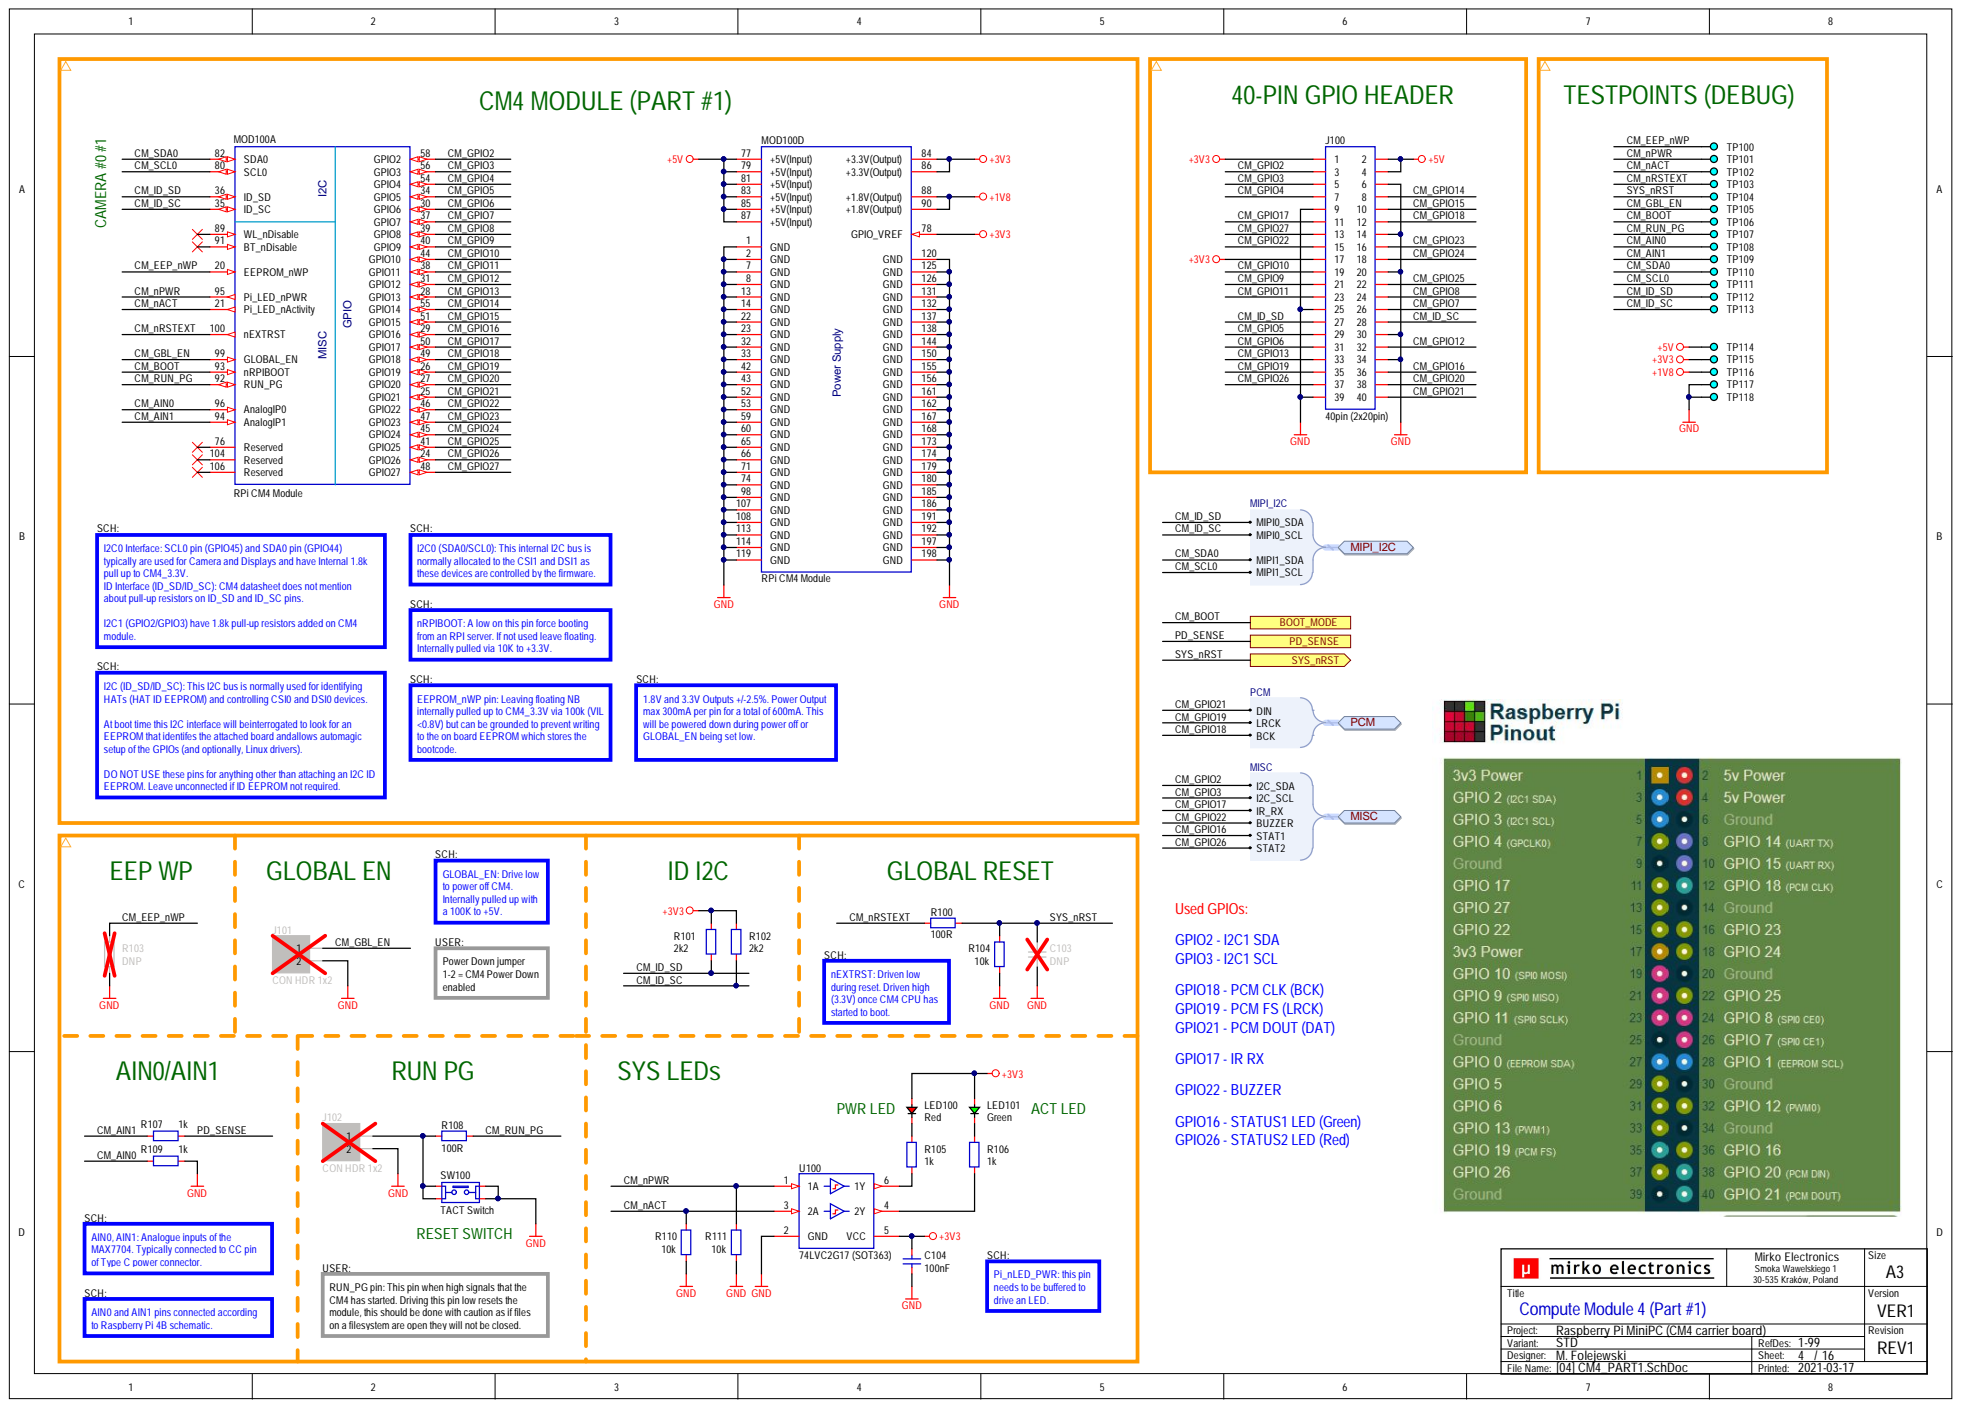
[picture p66: page 4]

SCH:
I2C0 Interface: SCL0 pin (GPIO45) and SDA0 pin (GPIO44)
typically are used for Camera and Displays and have Internal 1.8k
pull up to CM4_3.3V.
ID Interface (ID_SD/ID_SC): CM4 datasheet does not mention
about pull-up resistors on ID_SD and ID_SC pins.

I2C0 (SDA0/SCL0): This internal I2C bus is
normally allocated to the CSI1 and DSI1 as
these devices are controlled by the firmware.

nRPIBOOT: A low on this pin force booting
from an RPI server. If not used leave floating.
Internally pulled via 10K to +3.3V.

I2C1 (GPIO2/GPIO3) have 1.8k pull-up resistors added on CM4
module.

I2C (ID_SD/ID_SC): This I2C bus is normally used for identifying
HATs (HAT ID EEPROM) and controlling CSI0 and DSI0 devices.

EEPROM_nWP pin: Leaving floating NB
internally pulled up to CM4_3.3V via 100k (VIL
<0.8V) but can be grounded to prevent writing
to the on board EEPROM which stores the
bootcode.

1.8V and 3.3V Outputs +/-2.5%. Power Output
max 300mA per pin for a total of 600mA. This
will be powered down during power off or
GLOBAL_EN being set low.

At boot time this I2C interface will beinterrogated to look for an
EEPROM that identifes the attached board andallows automagic
setup of the GPIOs (and optionally, Linux drivers).

DO NOT USE these pins for anything other than attaching an I2C ID
EEPROM. Leave unconnected if ID EEPROM not required.

GLOBAL_EN: Drive low
to power off CM4.
Internally pulled up with

nEXTRST: Driven low
during reset. Driven high
(3.3V) once CM4 CPU has
started to boot.

AIN0, AIN1: Analogue inputs of the
MAX7704. Typically connected to CC pin
of Type C power connector.

Pi_nLED_PWR: this pin
needs to be buffered to
drive an LED.

Mirko Electronics Smoka Wawelskiego 1 30-535 Kraków, Poland | Size A3

USER:
RUN_PG pin: This pin when high signals that the
CM4 has started. Driving this pin low resets the
module, this should be done with caution as if files
on a filesystem are open they will not be closed.

AIN0 and AIN1 pins connected according
to Raspberry Pi 4B schematic.

Title Compute Module 4 (Part #1) | | Version VER1

Revision REV1
Variant: STD

File Name: [04] CM4_PART1.SchDoc | Printed:

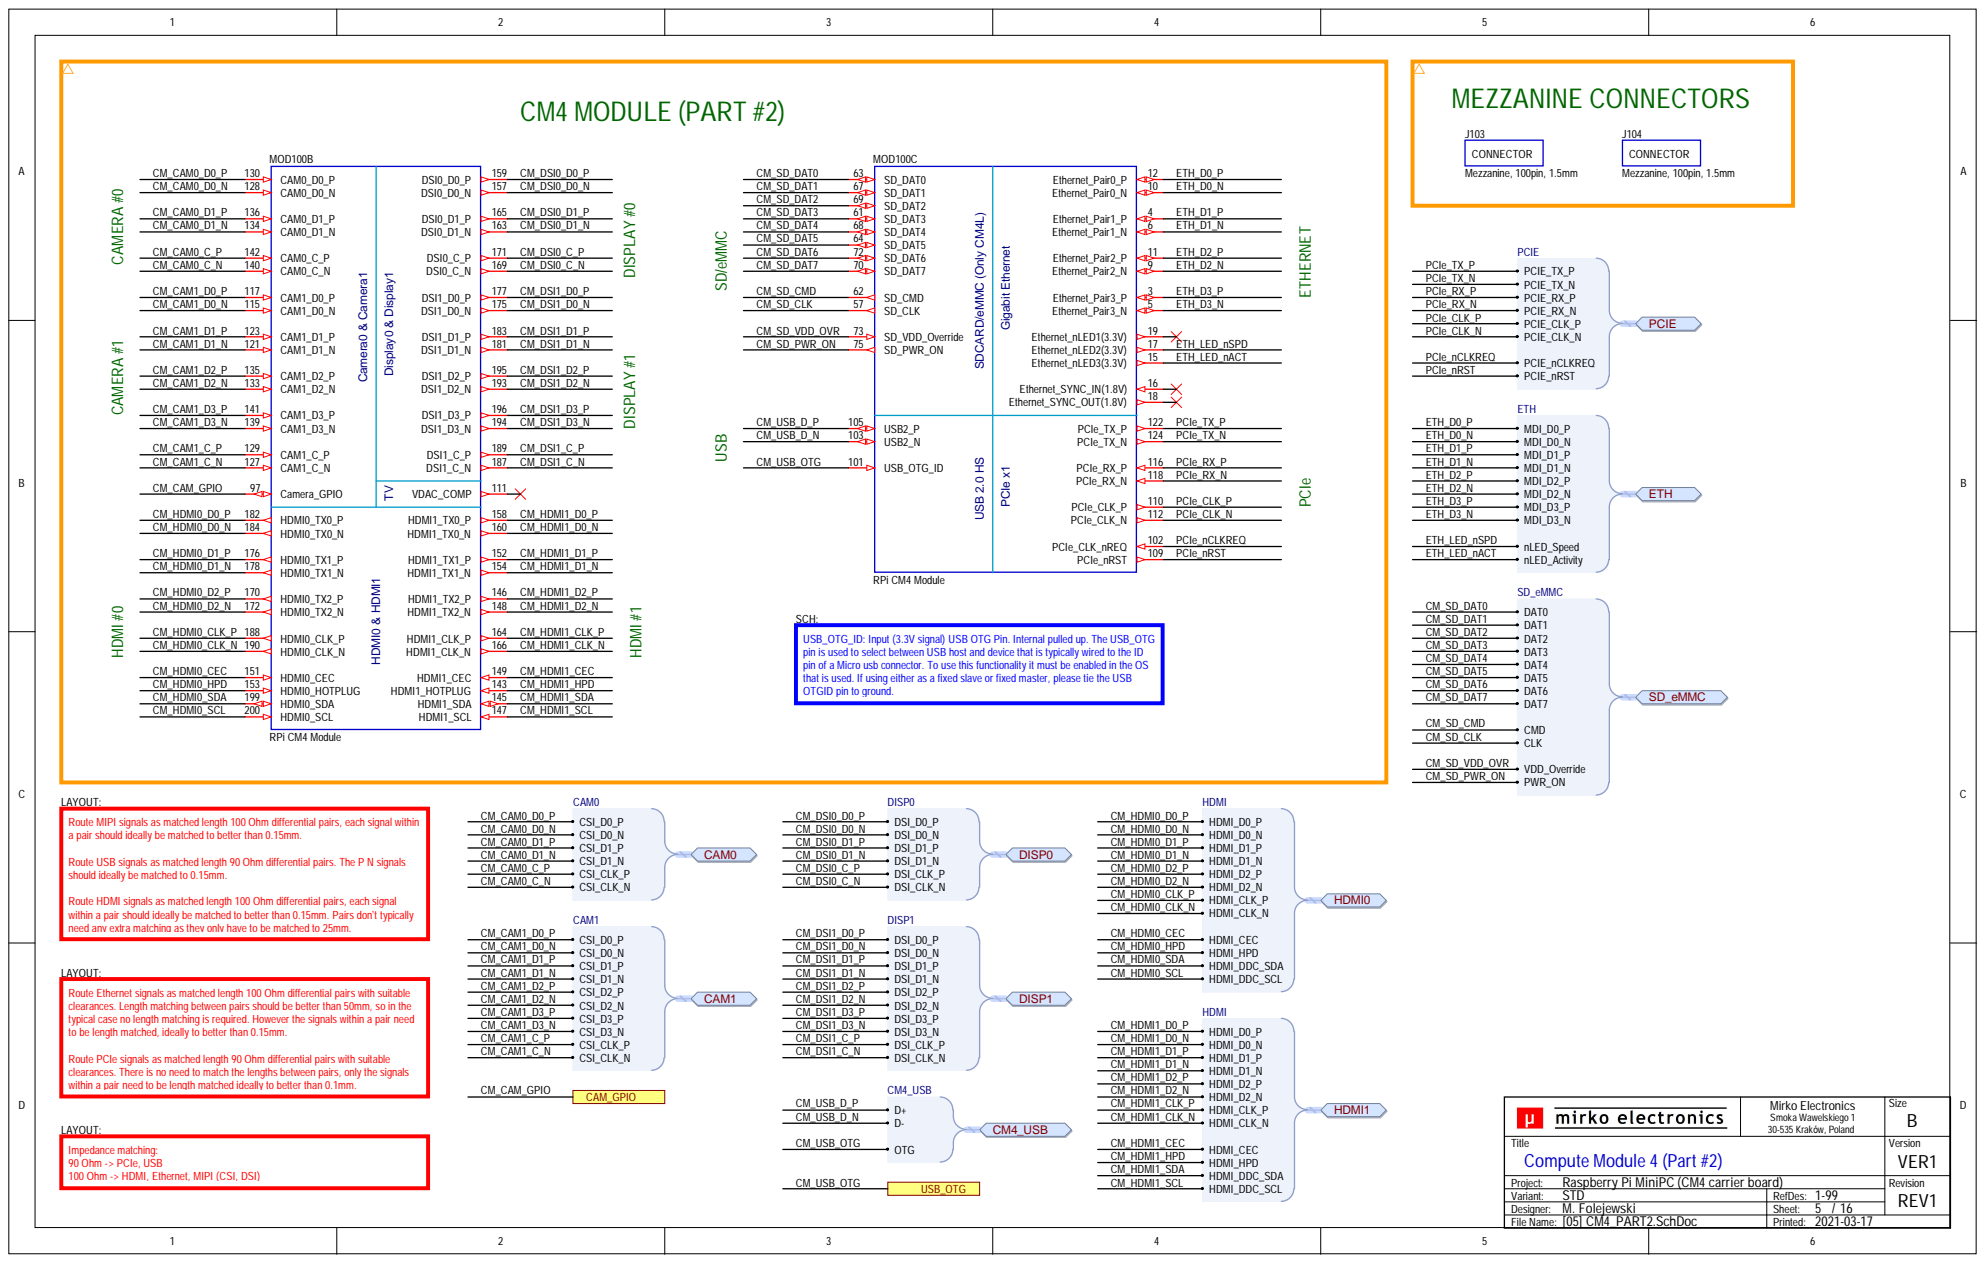
[picture p67: page 5]

SDCARD/eMMC (Only CM4L) USB 2.0 HS

SCH:
USB_OTG_ID: Input (3.3V signal) USB OTG Pin. Internal pulled up. The USB_OTG
pin is used to select between USB host and device that is typically wired to the ID
pin of a Micro usb connector. To use this functionality it must be enabled in the OS
that is used. If using either as a fixed slave or fixed master, please tie the USB
OTGID pin to ground.

LAYOUT:
Route MIPI signals as matched length 100 Ohm differential pairs, each signal within
a pair should ideally be matched to better than 0.15mm.

Route USB signals as matched length 90 Ohm differential pairs. The P N signals
should ideally be matched to 0.15mm.

Route HDMI signals as matched length 100 Ohm differential pairs, each signal
within a pair should ideally be matched to better than 0.15mm. Pairs don’t typically
need any extra matching as they only have to be matched to 25mm.

Route Ethernet signals as matched length 100 Ohm differential pairs with suitable
clearances. Length matching between pairs should be better than 50mm, so in the
typical case no length matching is required. However the signals within a pair need
to be length matched, ideally to better than 0.15mm.

Route PCIe signals as matched length 90 Ohm differential pairs with suitable
clearances. There is no need to match the lengths between pairs, only the signals
within a pair need to be length matched ideally to better than 0.1mm.

Impedance matching:
90 Ohm -> PCIe, USB
100 Ohm -> HDMI, Ethernet, MIPI (CSI, DSI)

Designer: M. Folejewski
File Name: [05] CM4_PART2.SchDoc | Printed:

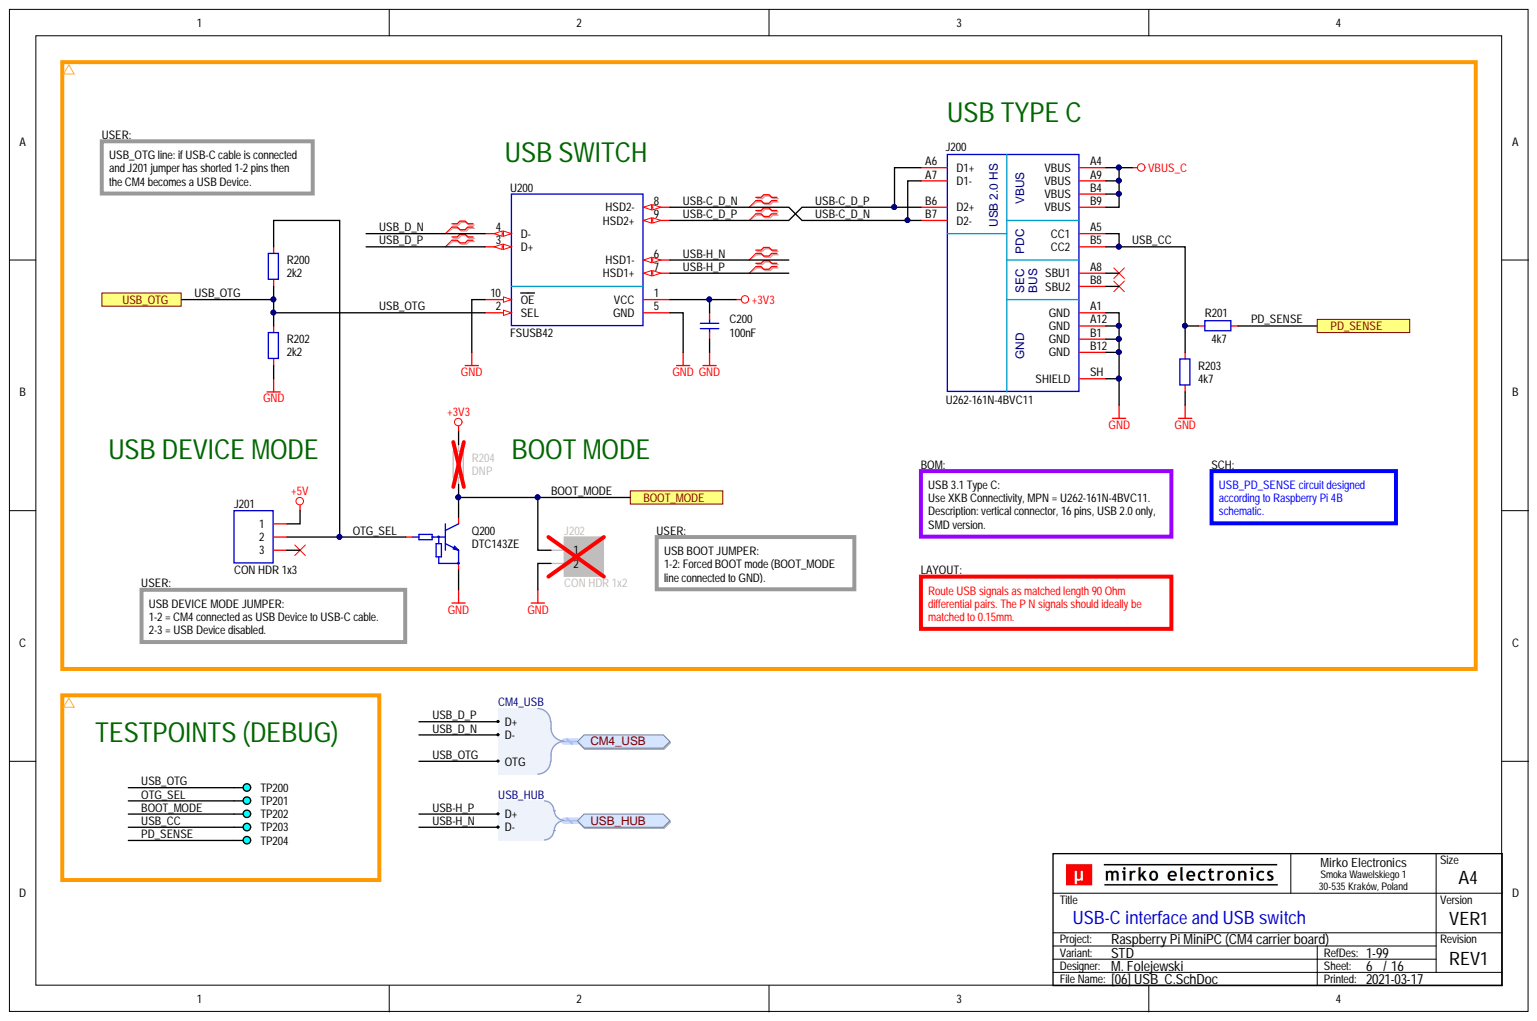
[picture p68: page 6]

USER:
USB_OTG line: if USB-C cable is connected
and J201 jumper has shorted 1-2 pins then
the CM4 becomes a USB Device.

D1+ A6 | VBUS
D1- A7
D2+ B6 | B4

GND VBUS PDC SEC

BOM:
USB 3.1 Type C:
Use XKB Connectivity, MPN = U262-161N-4BVC11.
Description: vertical connector, 16 pins, USB 2.0 only,
SMD version.

SCH:
USB_PD_SENSE circuit designed
according to Raspberry Pi 4B
schematic.

USB BOOT JUMPER:
1-2: Forced BOOT mode (BOOT_MODE
line connected to GND).

LAYOUT:
Route USB signals as matched length 90 Ohm
differential pairs. The P N signals should ideally be
matched to 0.15mm.

USB DEVICE MODE JUMPER:
1-2 = CM4 connected as USB Device to USB-C cable.
2-3 = USB Device disabled.

Mirko Electronics Smoka Wawelskiego 1 30-535 Kraków, Poland | Size A4

Title USB-C interface and USB switch | | Version VER1

Project: Raspberry Pi MiniPC (CM4 carrier board) | | Revision REV1
Variant: STD | RefDes: 1-99

File Name: [06] USB_C.SchDoc | Printed:

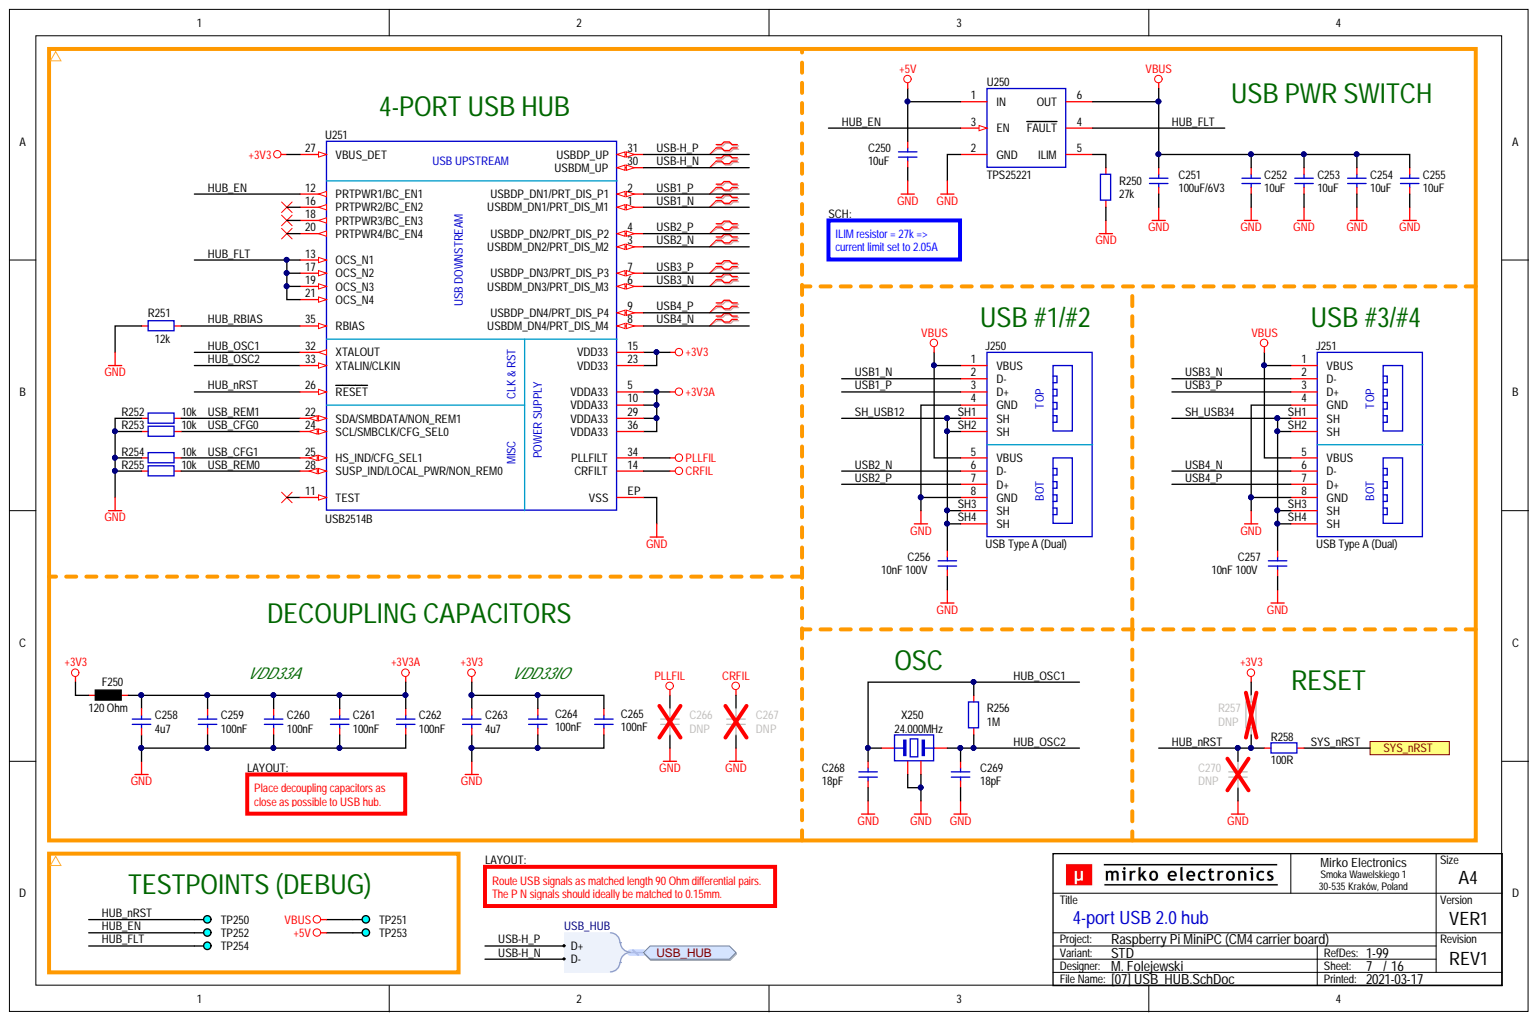
[picture p69: page 7]

SCH:
ILIM resistor = 27k =>
current limit set to 2.05A

LAYOUT:
Place decoupling capacitors as
close as possible to USB hub.

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

Mirko Electronics Smoka Wawelskiego 1

File Name: [07] USB_HUB.SchDoc | Printed:

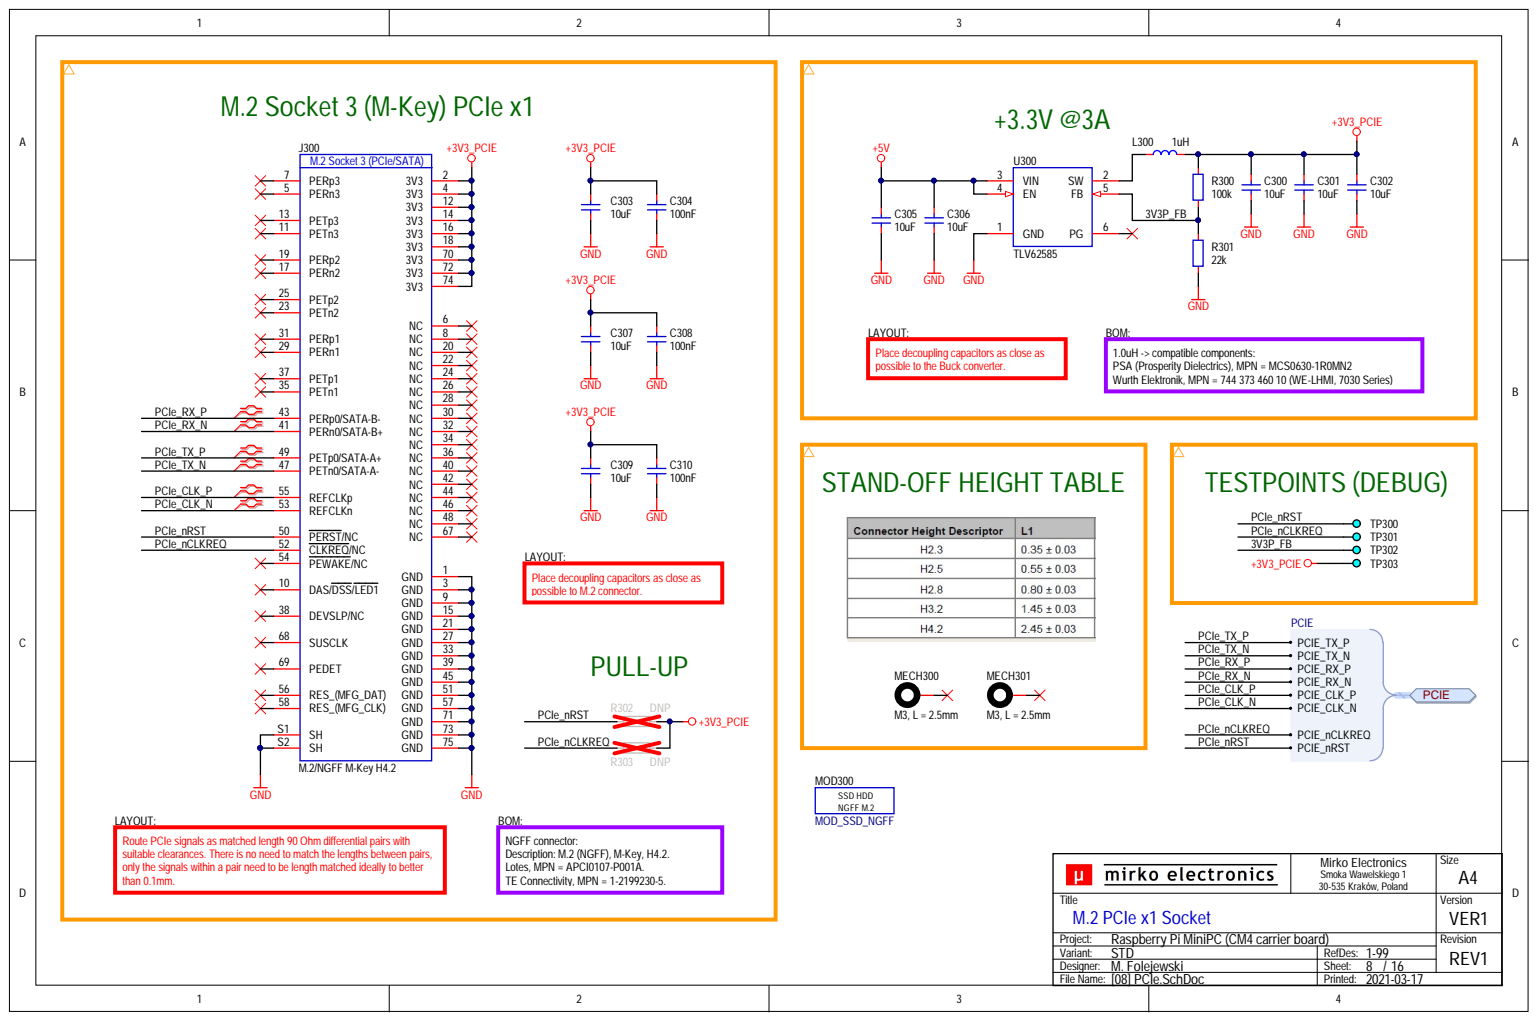
[picture p70: page 8]

LAYOUT
Place decoupling ca
possible to the Buck converter.

BOM:
1.0uH -> compatible components:
PSA (Prosperity Dielectrics), MPN = MCS0630-

pacitors as close as

Route PCIe signals as matched le
suita
only the signals within a pair need to be le
tha

here is no need to match the le

ngth matched ideally to better

Mirko Electro n ics Smoka Wawelskiego 1 30-535 Kraków, Poland | Size A4

Title M.2 PCIe x1 Socket | | Ve rsion VER1

Project: Raspberry Pi MiniPC (CM4 carrier board) | | Revision REV1
STD Va ria nt: | 1-99 RefDes:
Designer: M. Folejews ki | Sheet: 8 / 1 6
File Na me: [08] PCIe.S chDoc | Printed : 2021-03-1 7

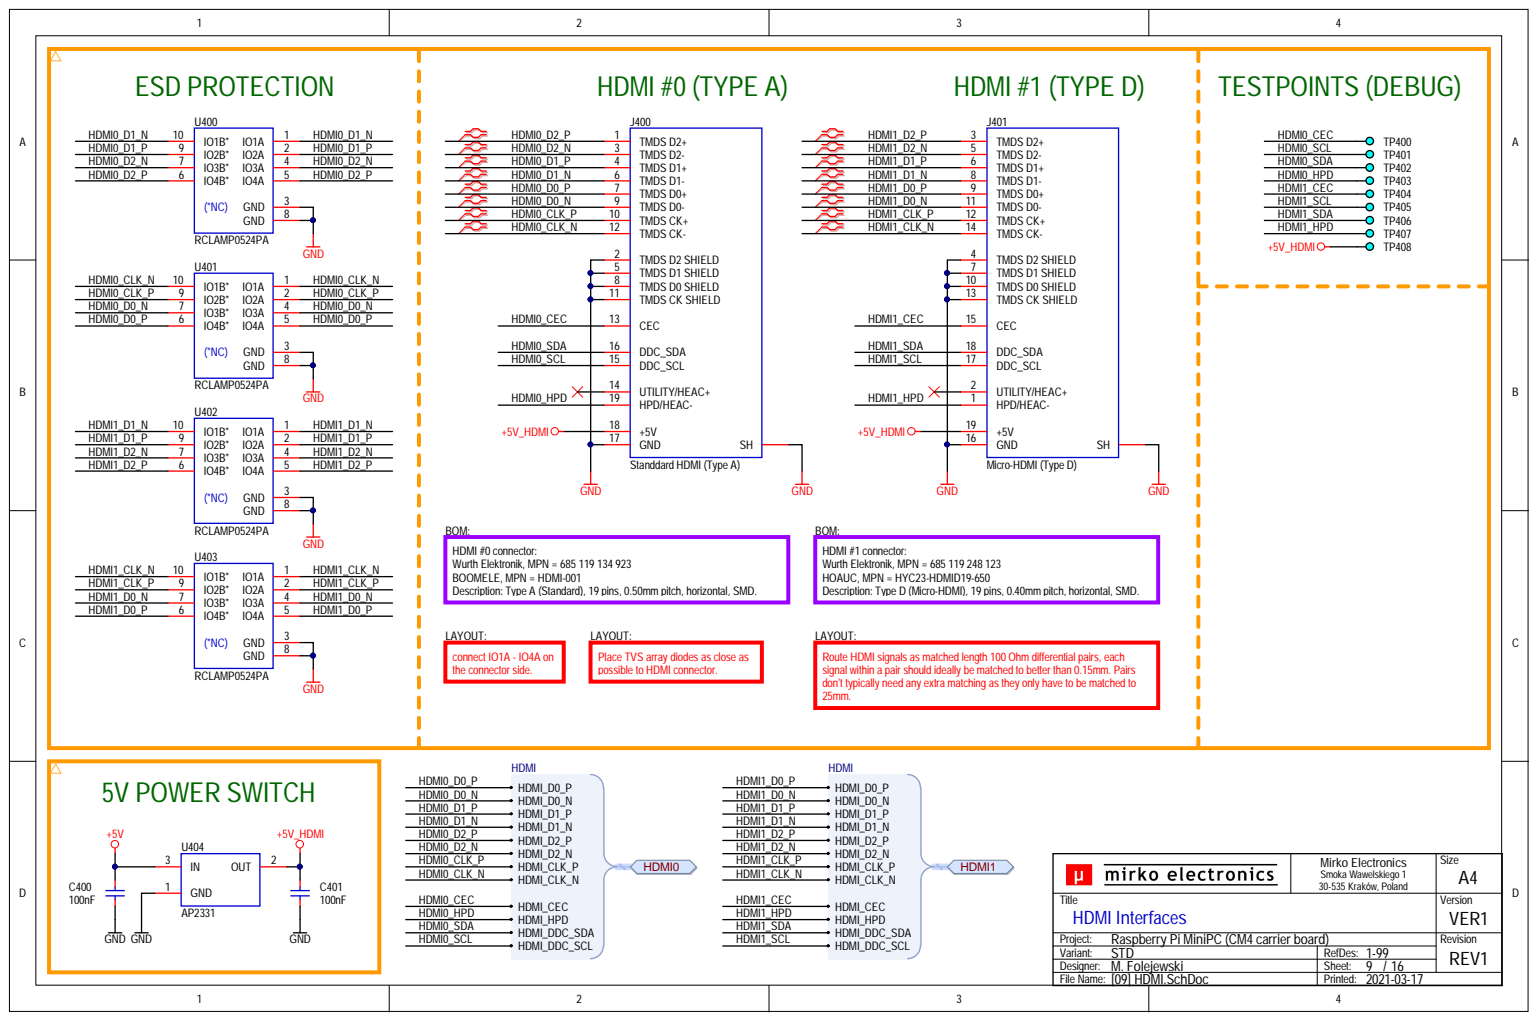
[picture p71: page 9]

2 HDMI0_D1 _P | HDMI0_D2_N 3 | HDMI1 _D2_N 5
4 HDMI0_D2_N | HDMI0_D1 _P 4 | HDMI1 _D1 _P 6
5 HDMI0_D2_P | HDMI0_D1 _N 6 | HDMI1 _D1 _N 8
3 | HDMI0_D0_P 7 | HDMI1 _D0_P 9

BOM:
HDMI #1 connector:
HOAUC, MPN = HYC23-HDMID1
Description: Type D (Micro-HDMI), 1

9 pins, 0.50mm pitch, horizontal, SMD.

LAYOUT
Place TVS a
possible to HDMI connector.

rray diodes as close as

Route HDMI signals as matched le
signal within a pair should ideally be matched to better tha
don’t typically need a

ny extra matching as they only have to be matched to

Project: Raspberry Pi MiniPC (CM4 carrier board) | Revision REV1
STD Va ria nt: | 1-99 RefDes:
Designer: M. Folejews ki | Sheet: 9 / 1 6
File Na me: [09] HDMI.S chDoc | Printed : 2021-03-1 7

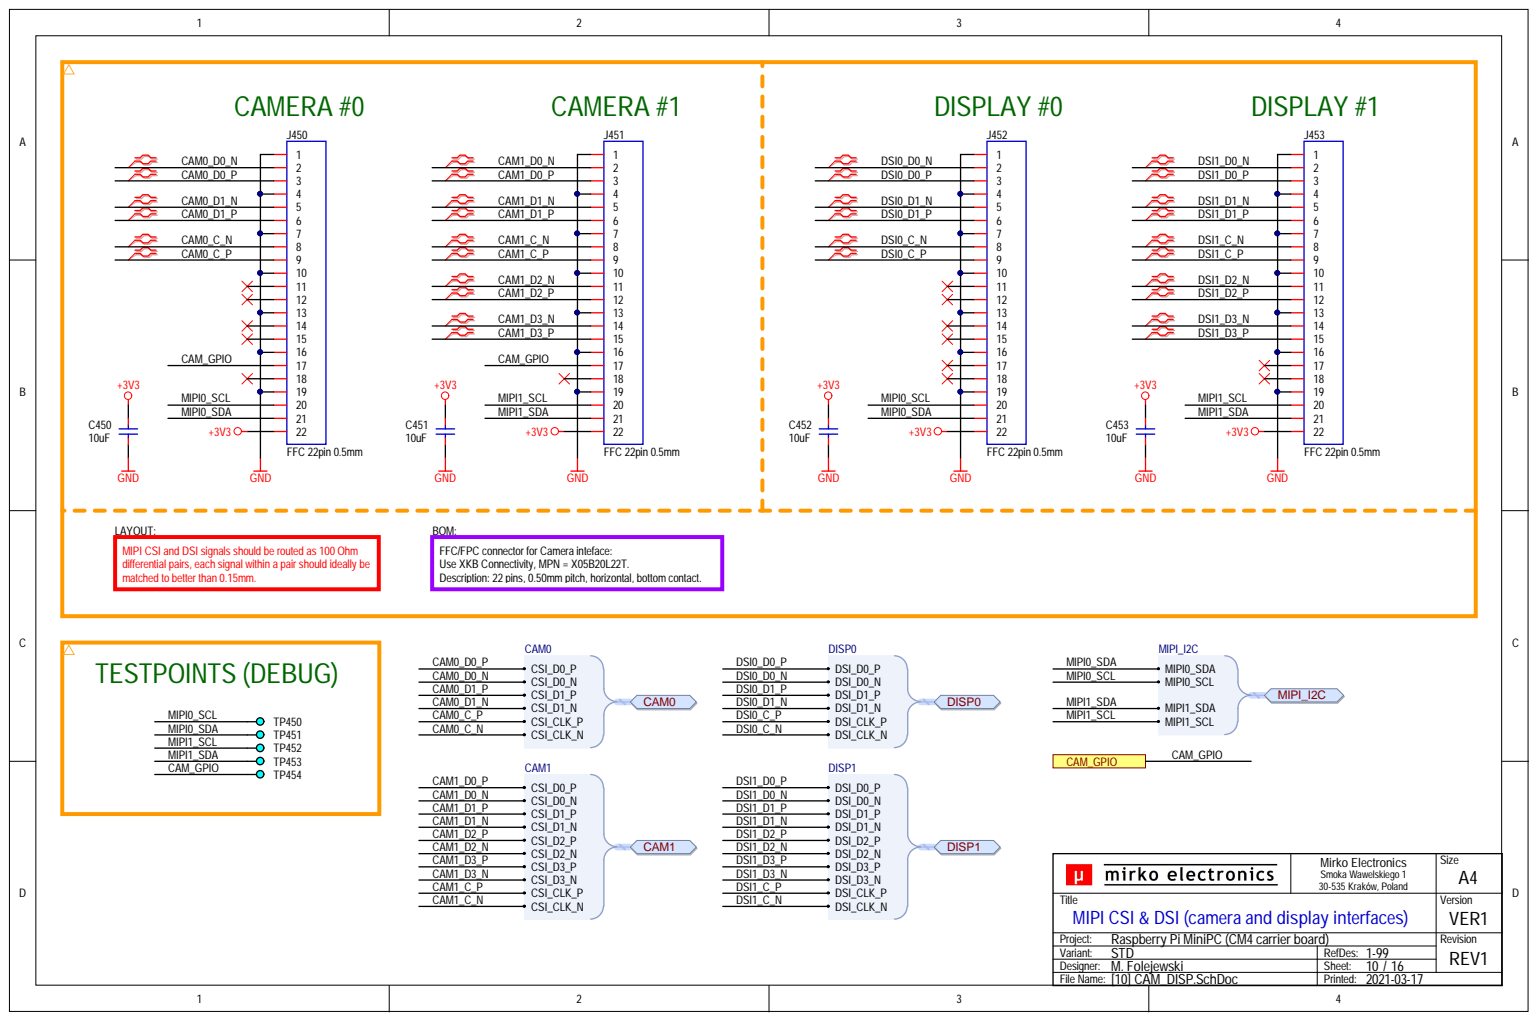
[picture p72: page 10]

LAYOUT:
MIPI CSI and DSI signals should be routed as 100 Ohm
differential pairs, each signal within a pair should ideally be
matched to better than 0.15mm.

BOM:
FFC/FPC connector for Camera inteface:
Use XKB Connectivity, MPN = X05B20L22T.
Description: 22 pins, 0.50mm pitch, horizontal, bottom contact.

Mirko Electronics Smoka Wawelskiego 1

Project: Raspberry Pi MiniPC (CM4 carrier board) | Revision REV1
Variant: STD | RefDes: 1-99

File Name: [10] CAM_DISP.SchDoc | Printed:

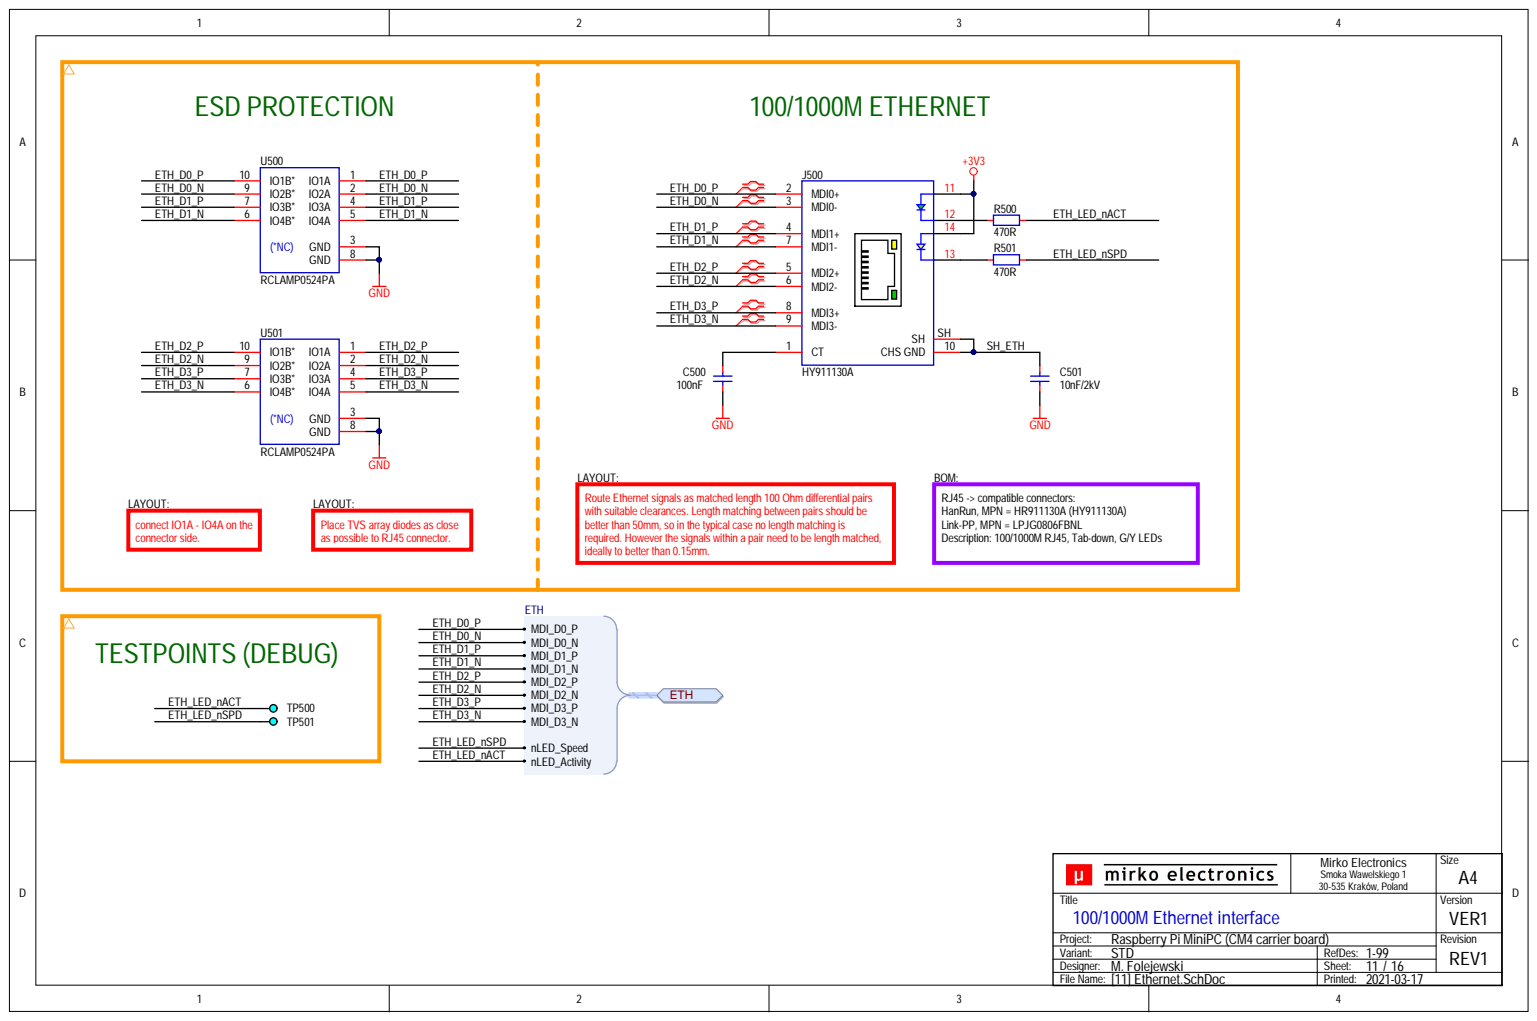
[picture p73: page 11]

LAYOUT:
Route Ethernet signals as matched length 100 Ohm differential pairs
with suitable clearances. Length matching between pairs should be
better than 50mm, so in the typical case no length matching is
required. However the signals within a pair need to be length matched,
ideally to better than 0.15mm.

BOM:
RJ45 -> compatible connectors:
HanRun, MPN = HR911130A (HY911130A)
Link-PP, MPN = LPJG0806FBNL
Description: 100/1000M RJ45, Tab-down, G/Y LEDs

Place TVS array diodes as close
as possible to RJ45 connector.

Mirko Electronics Smoka Wawelskiego 1 30-535 Kraków, Poland | Size A4

Title 100/1000M Ethernet interface | | Version VER1

Project: Raspberry Pi MiniPC (CM4 carrier board) | | Revision REV1
Variant: STD | RefDes: 1-99

File Name: [11] Ethernet.SchDoc | Printed:

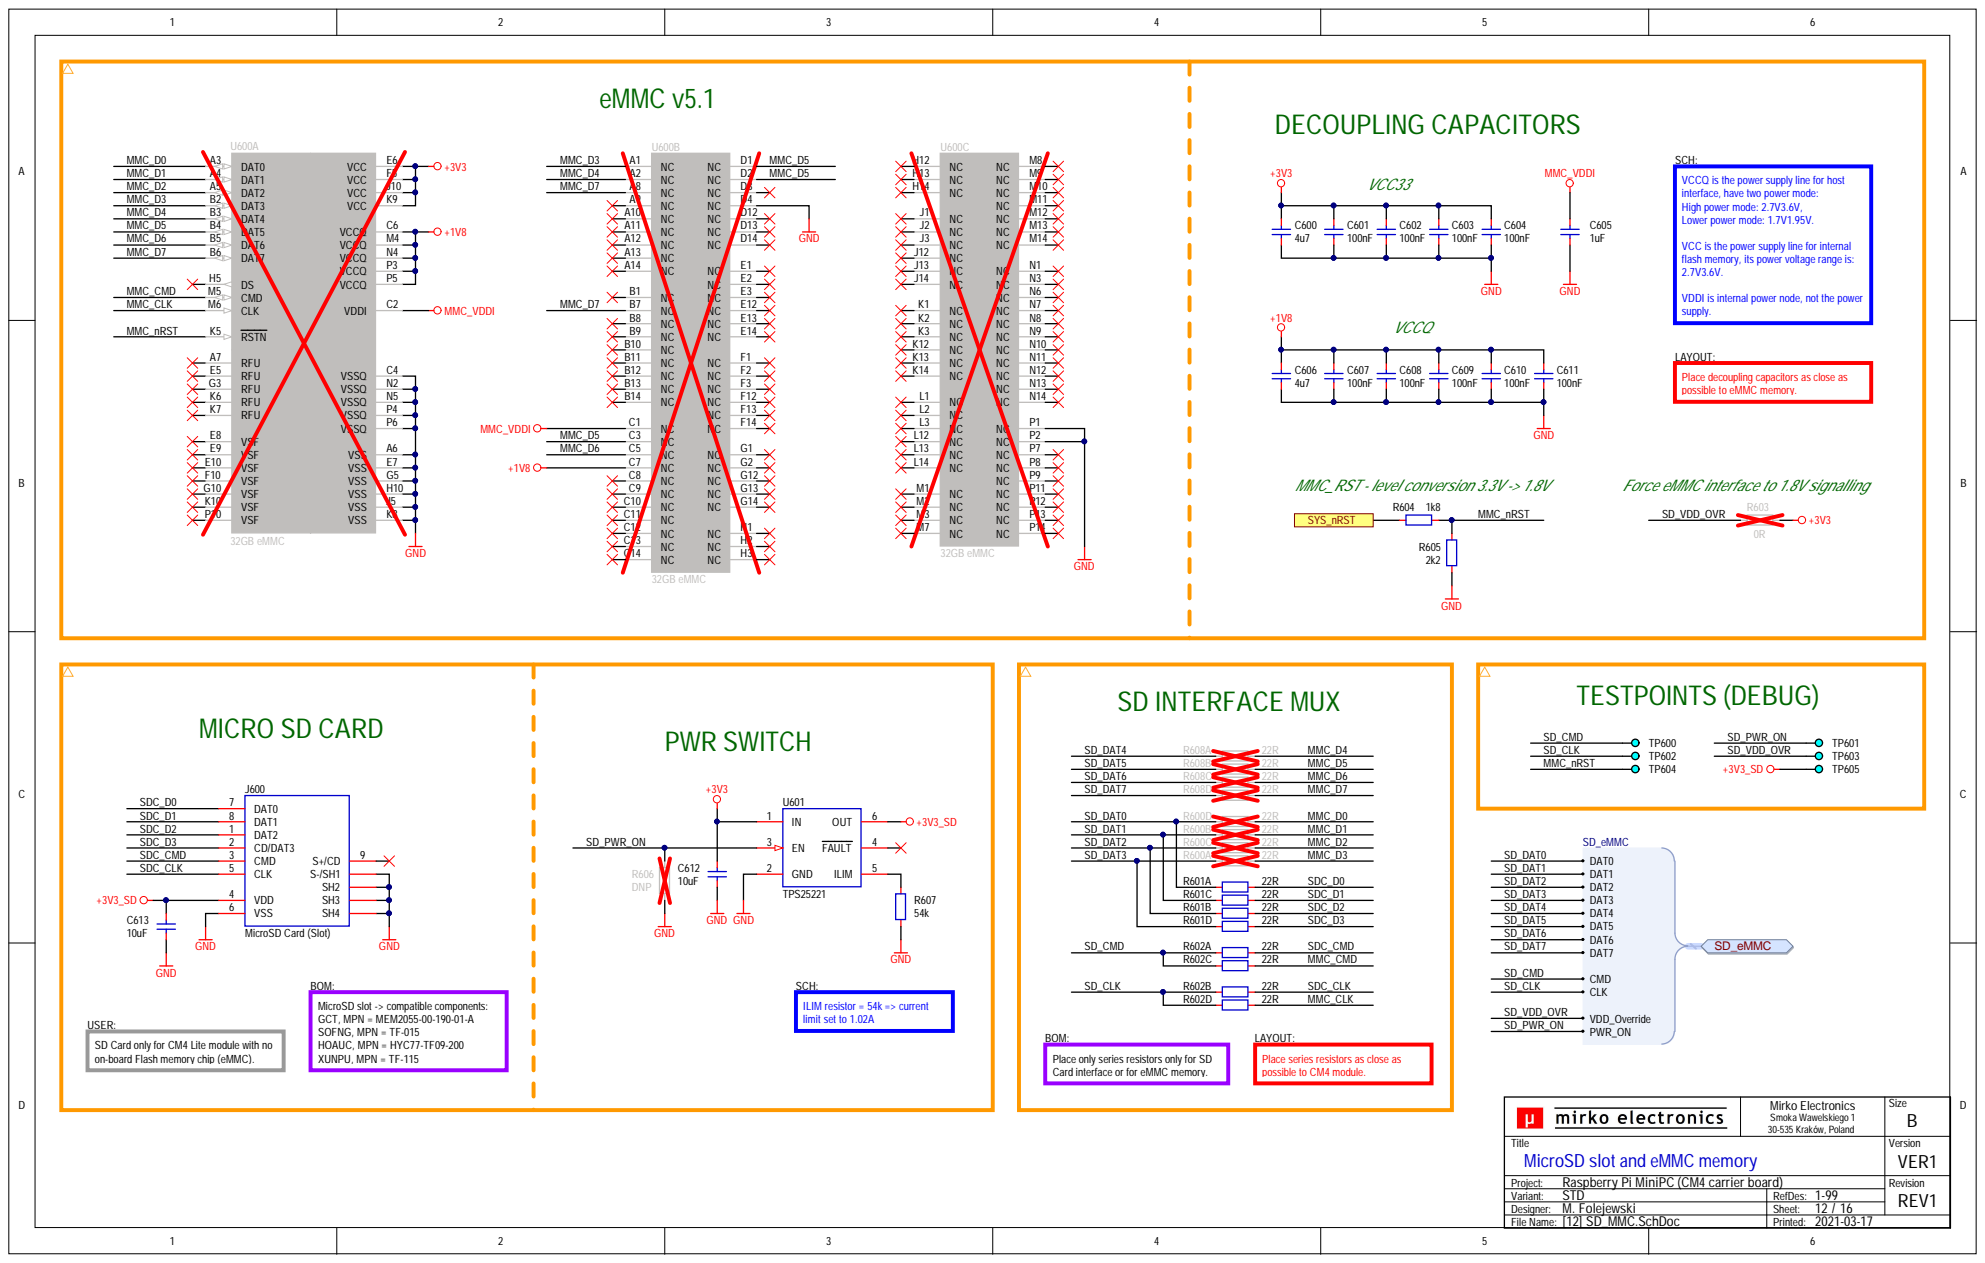
[picture p74: page 12]

internal power node, not

tors as close as
memory.

resistors as close as

Mirko Electronics Smoka Wawel s k i ego 1 30-535 Kra kó w, Pol a nd | Size B

Ti tl e MicroSD slot and eMMC me mory | | Version V ER1

Project: Raspberry Pi MiniPC (CM4 carr ier board) | | Revision RE V 1
Variant: STD | RefDes: 1-99
Designer: M. Folejewski | Sheet:
Fi le Name: [12] SD_MMC.SchDoc | Printed:

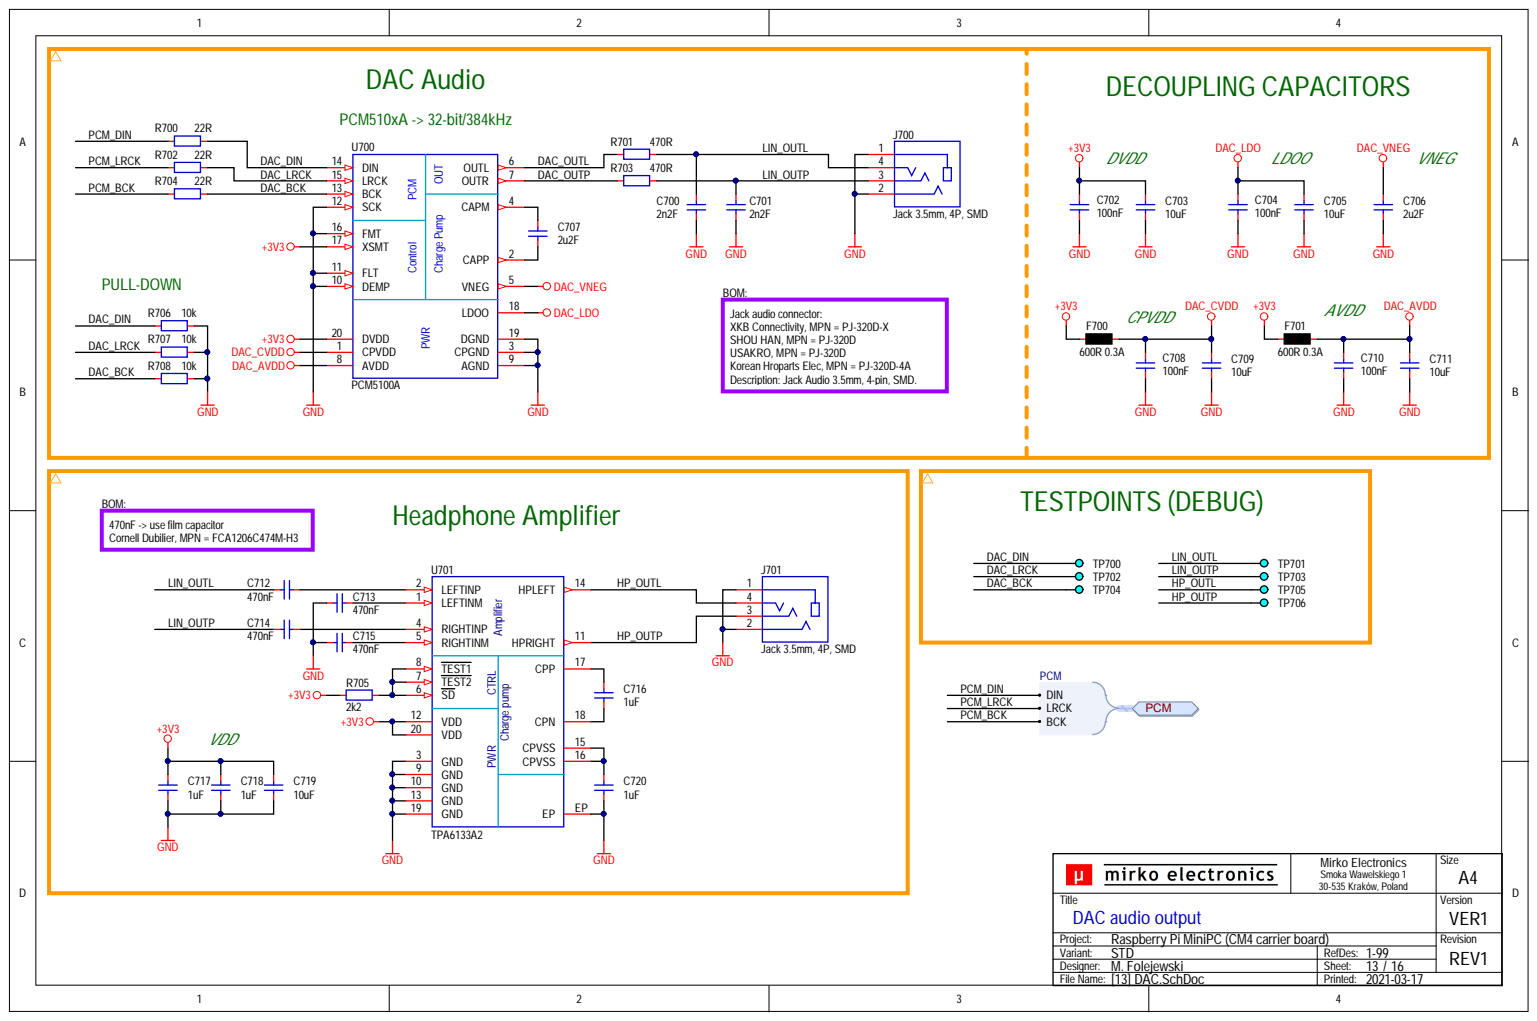
[picture p75: page 13]

DAC_LRCK | | LIN_OUTP | | 3

BCK 13 | BOM: | | 2

Jack audio connector:
XKB Connectivity, MPN = PJ-320D-X
SHOU HAN, MPN = PJ-320D
USAKRO, MPN = PJ-320D
Korean Hroparts Elec, MPN = PJ-320D-4A
Description: Jack Audio 3.5mm, 4-pin, SMD.

RIGHTINP 4 RIGHTINM 5 | | 3

HP_OUTP | 2

Mirko Electronics Smoka Wawelskiego 1 30-535 Kraków, Poland | Size A4

Title DAC audio output | | Version VER1

Project: Raspberry Pi MiniPC (CM4 carrier board) | | Revision REV1
Variant: STD | RefDes: 1-99

File Name: [13] DAC.SchDoc | Printed:

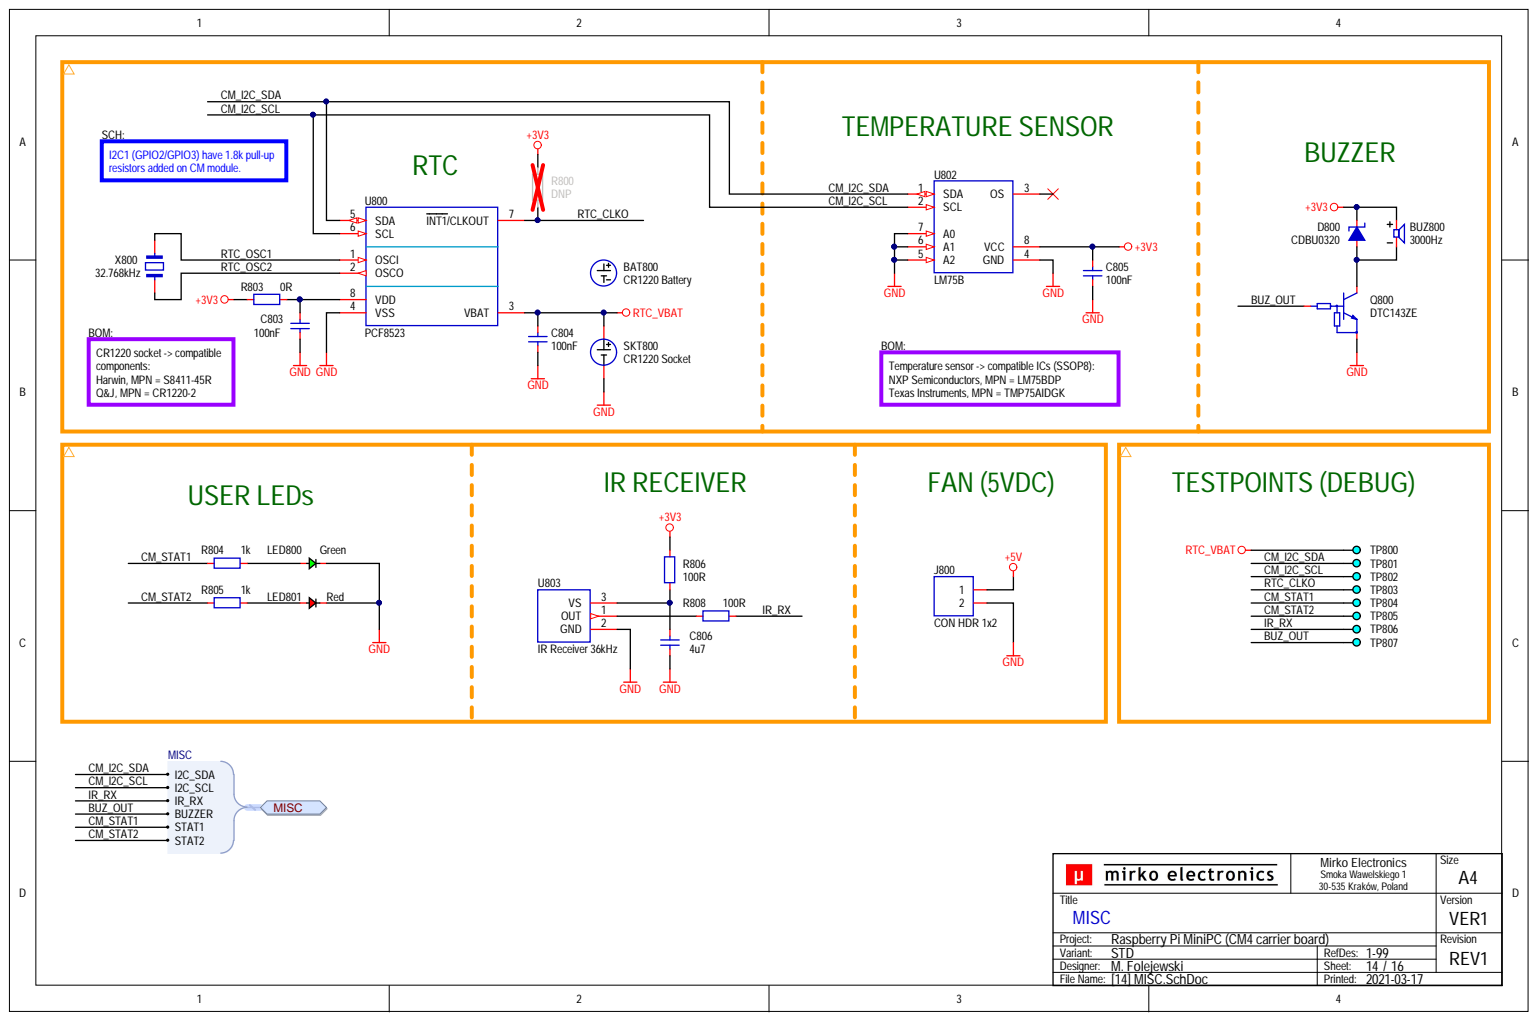
[picture p76: page 14]

CM_I2C_SDA | TEMPERATURE SENSOR | BUZZER
CM_I2C_SCL

+3V3 | CM_I2C_SDA

I2C1 (GPIO2/GPIO3) have 1.8k pull-up resistors added on CM module.

BOM:
Temperature sensor -> compatible ICs (SSOP8):
NXP Semiconductors, MPN = LM75BDP
Texas Instruments, MPN = TMP75AIDGK

Mirko Electronics Smoka Wawelskiego 1 30-535 Kraków, Poland | Size A4

Title MISC | | Version VER1

Project: Raspberry Pi MiniPC (CM4 carrier board) | | Revision REV1
Variant: STD | RefDes: 1-99

File Name: [14] MISC.SchDoc | Printed:

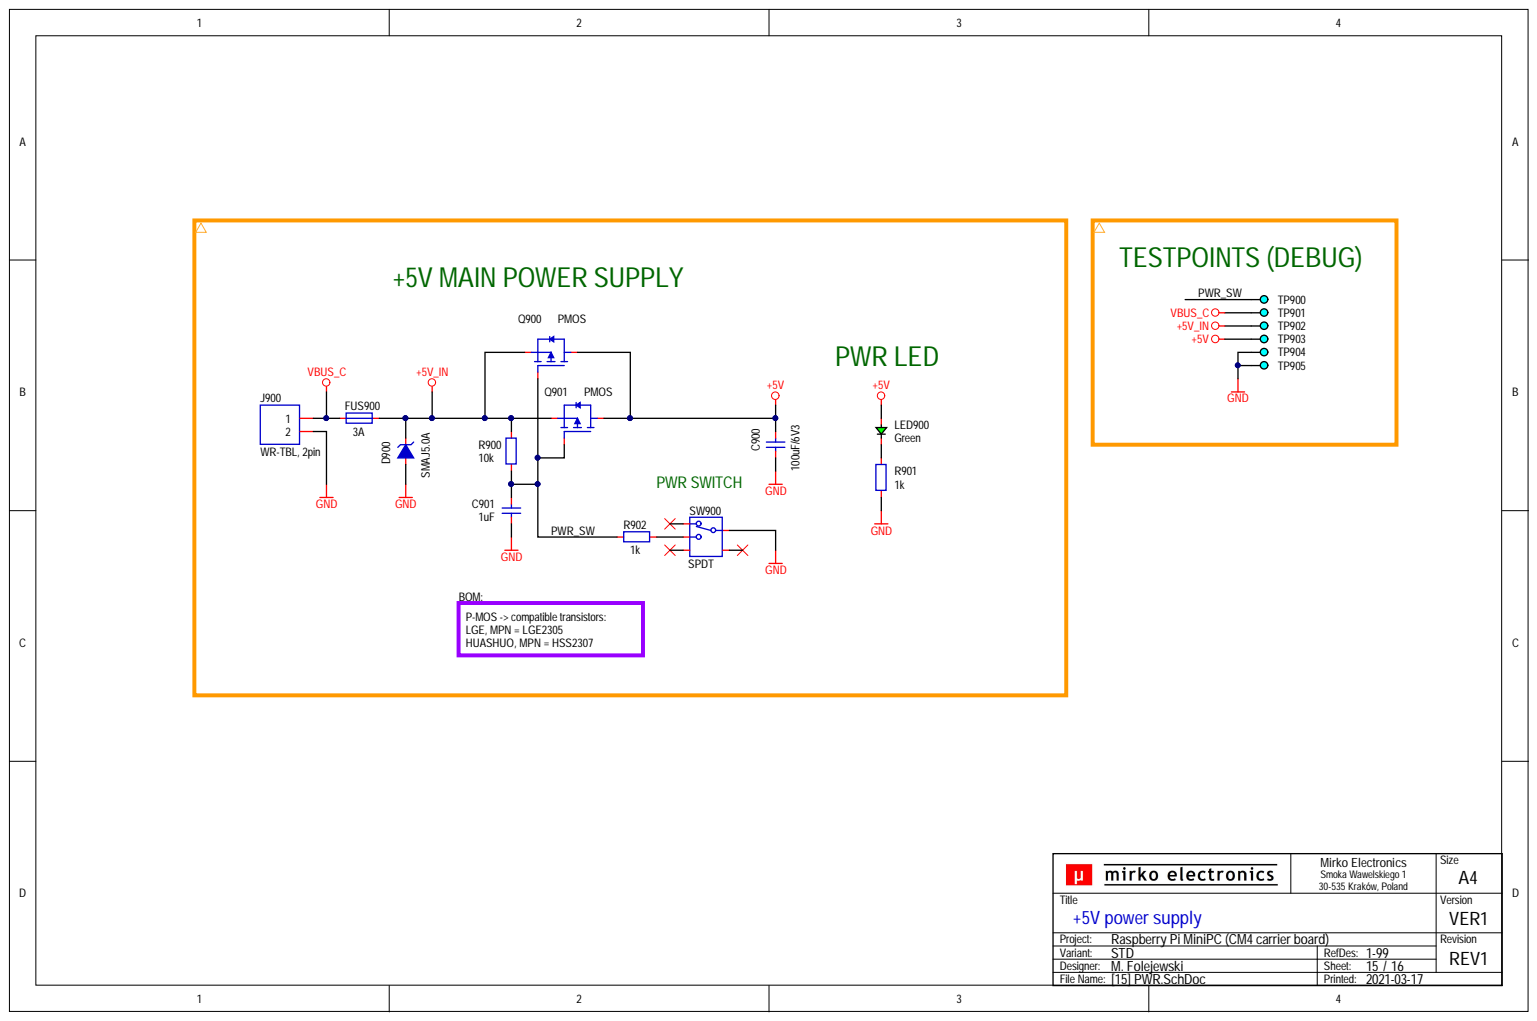
[picture p77: page 15]

Mirko Electro n ics Smoka Wawelskiego 1 30-535 Kraków, Poland | Size A4

Title +5V power suppl y | | Ve rsion VER1

Project: Raspberry Pi MiniPC (CM4 carrier board) | | Revision REV1
STD Va ria nt: | 1-99 RefDes:
Designer: M. Folejews ki | Sheet: 1 5 / 1 6
File Na me: [1 5] PWR.S chDoc | Printed : 2021-03-1 7

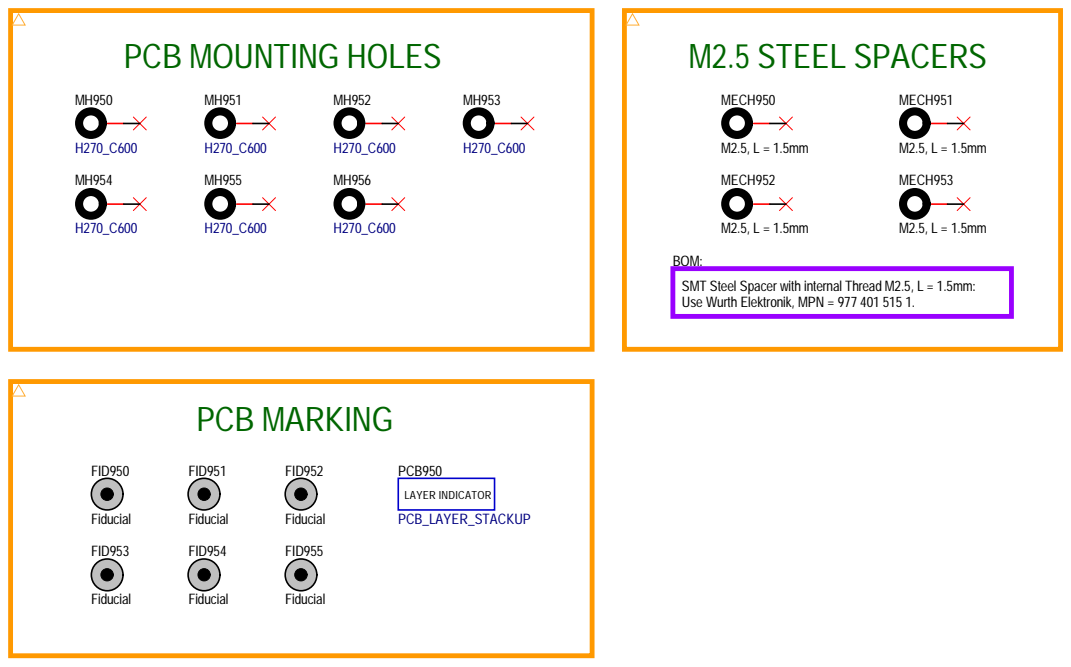
[picture p78: page 16]

BOM:
SMT Steel Spacer with internal Thread M2.5, L = 1.5mm:
Use Wurth Elektronik, MPN = 977 401 515 1.

Mirko Electronics Smoka Wawelskiego 1 30-535 Kraków, Poland | Size A4

Title PCB marking & mechanical parts | | Version VER1

Project: Raspberry Pi MiniPC (CM4 carrier board) | | Revision REV1
Variant: STD | RefDes: 1-99

File Name: [16] PCB_Mech.SchDoc | Printed:
