mfolejewski/MirkoPC/MirkoPC_REV1_Assembly_20210327.pdf

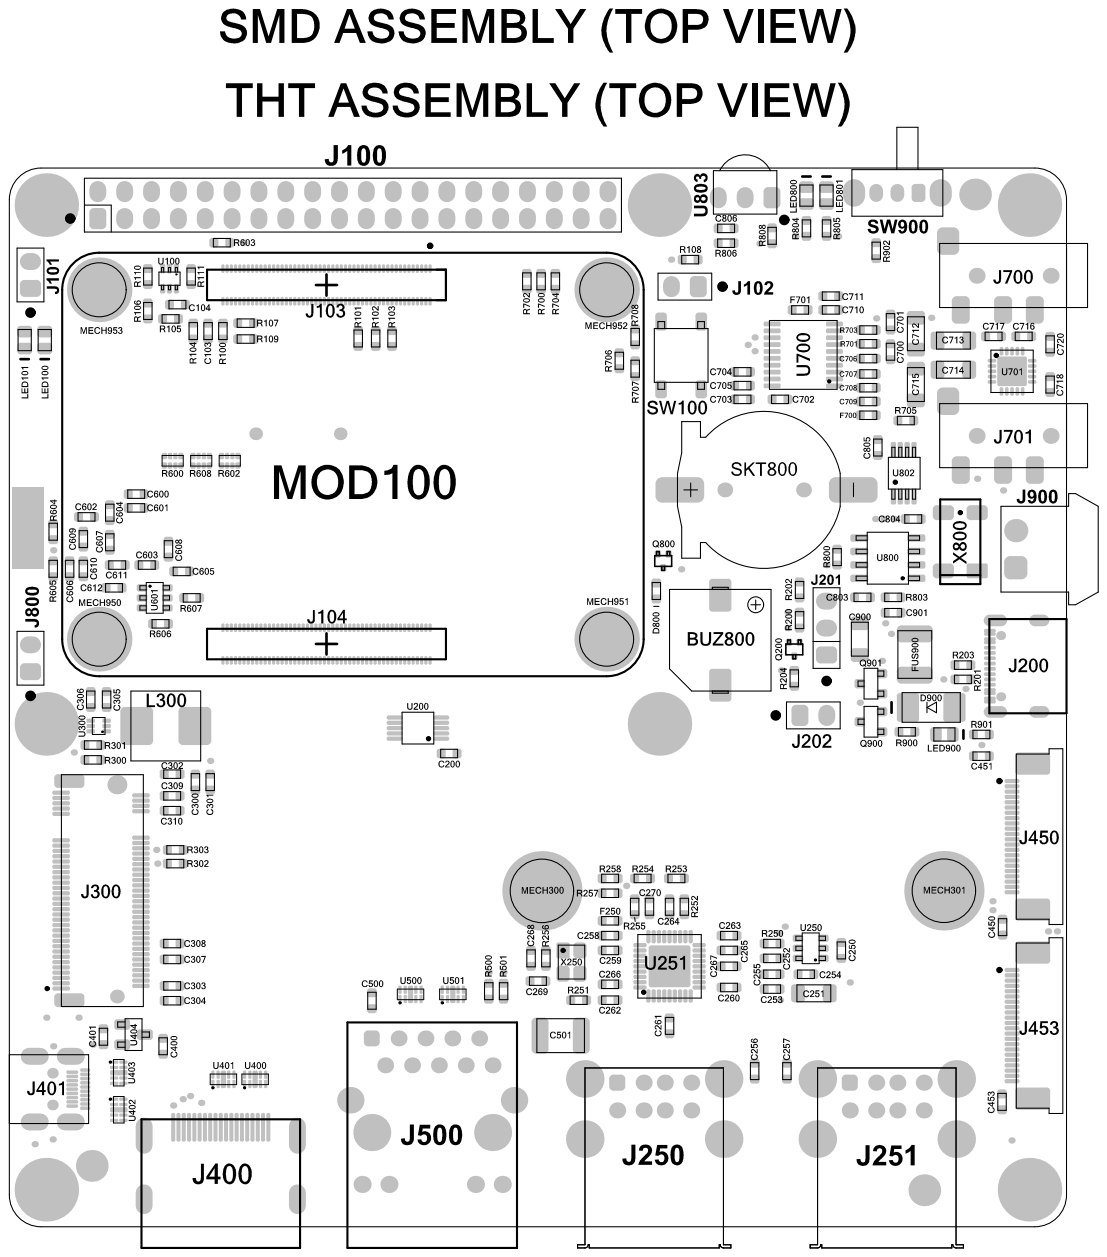
[picture p96: page 1]

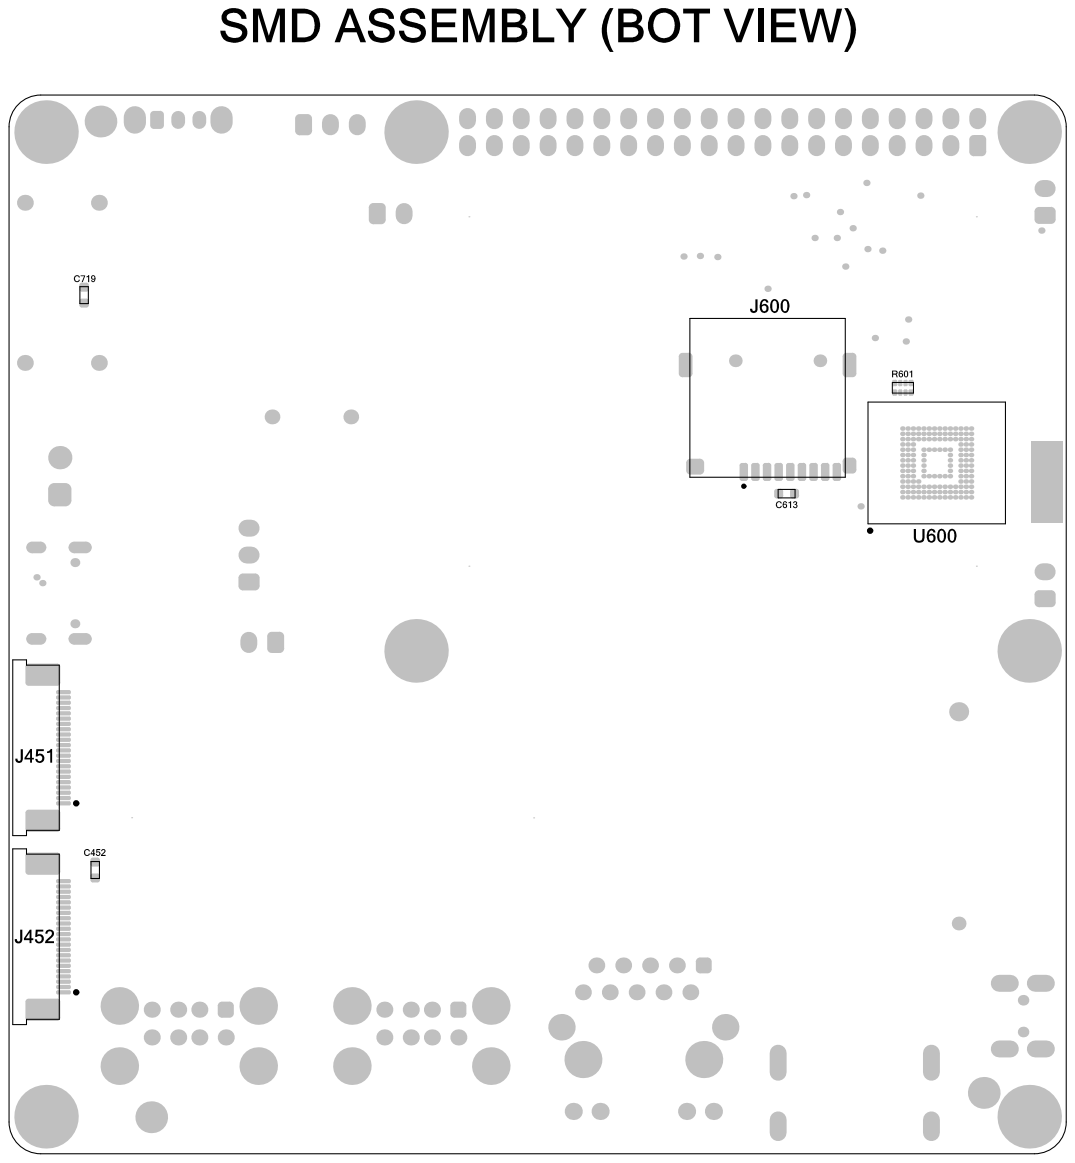
[picture p97: page 2]
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
