mfolejewski/MirkoPC/MirkoPC_REV1_Mechanical_dimensions_20210406.pdf

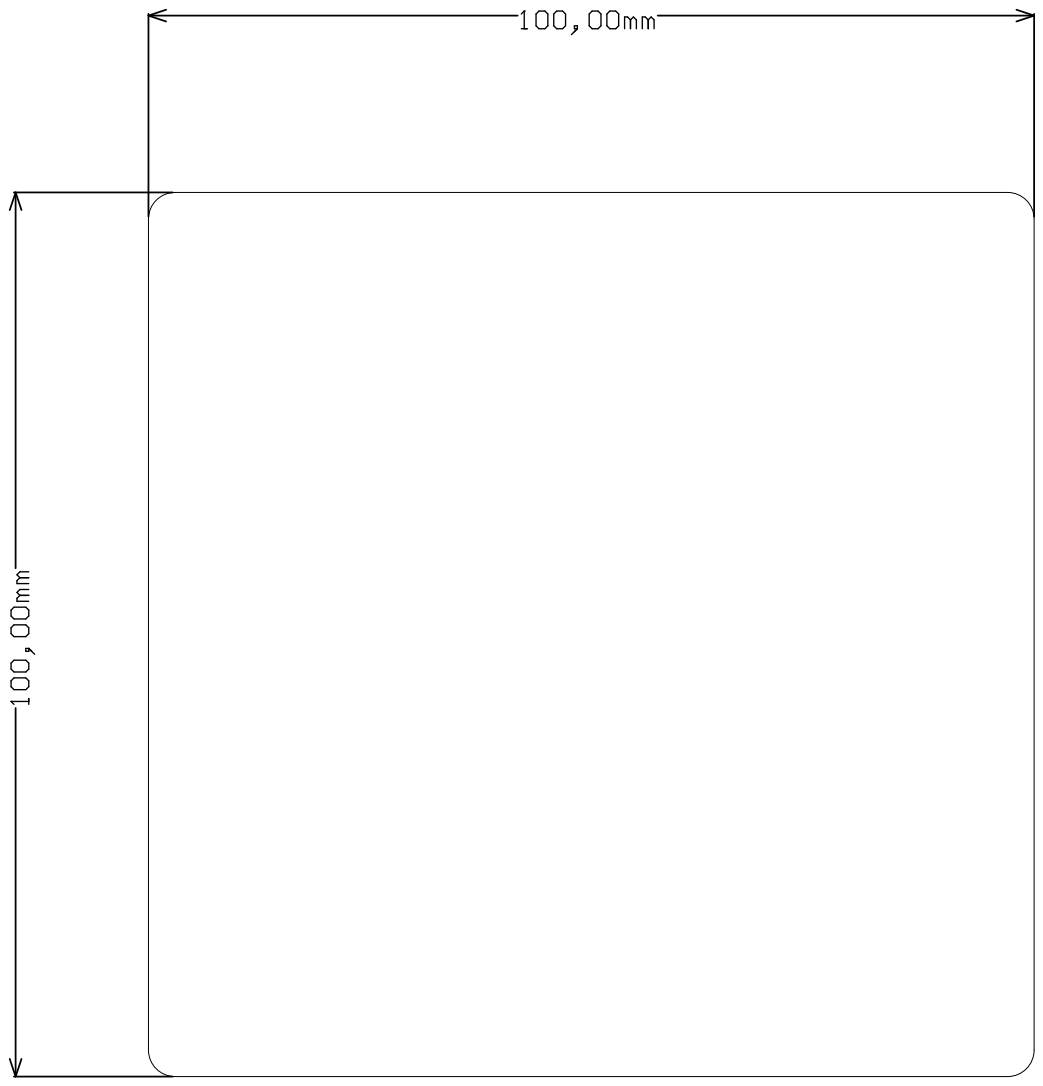
[picture p98: page 1]

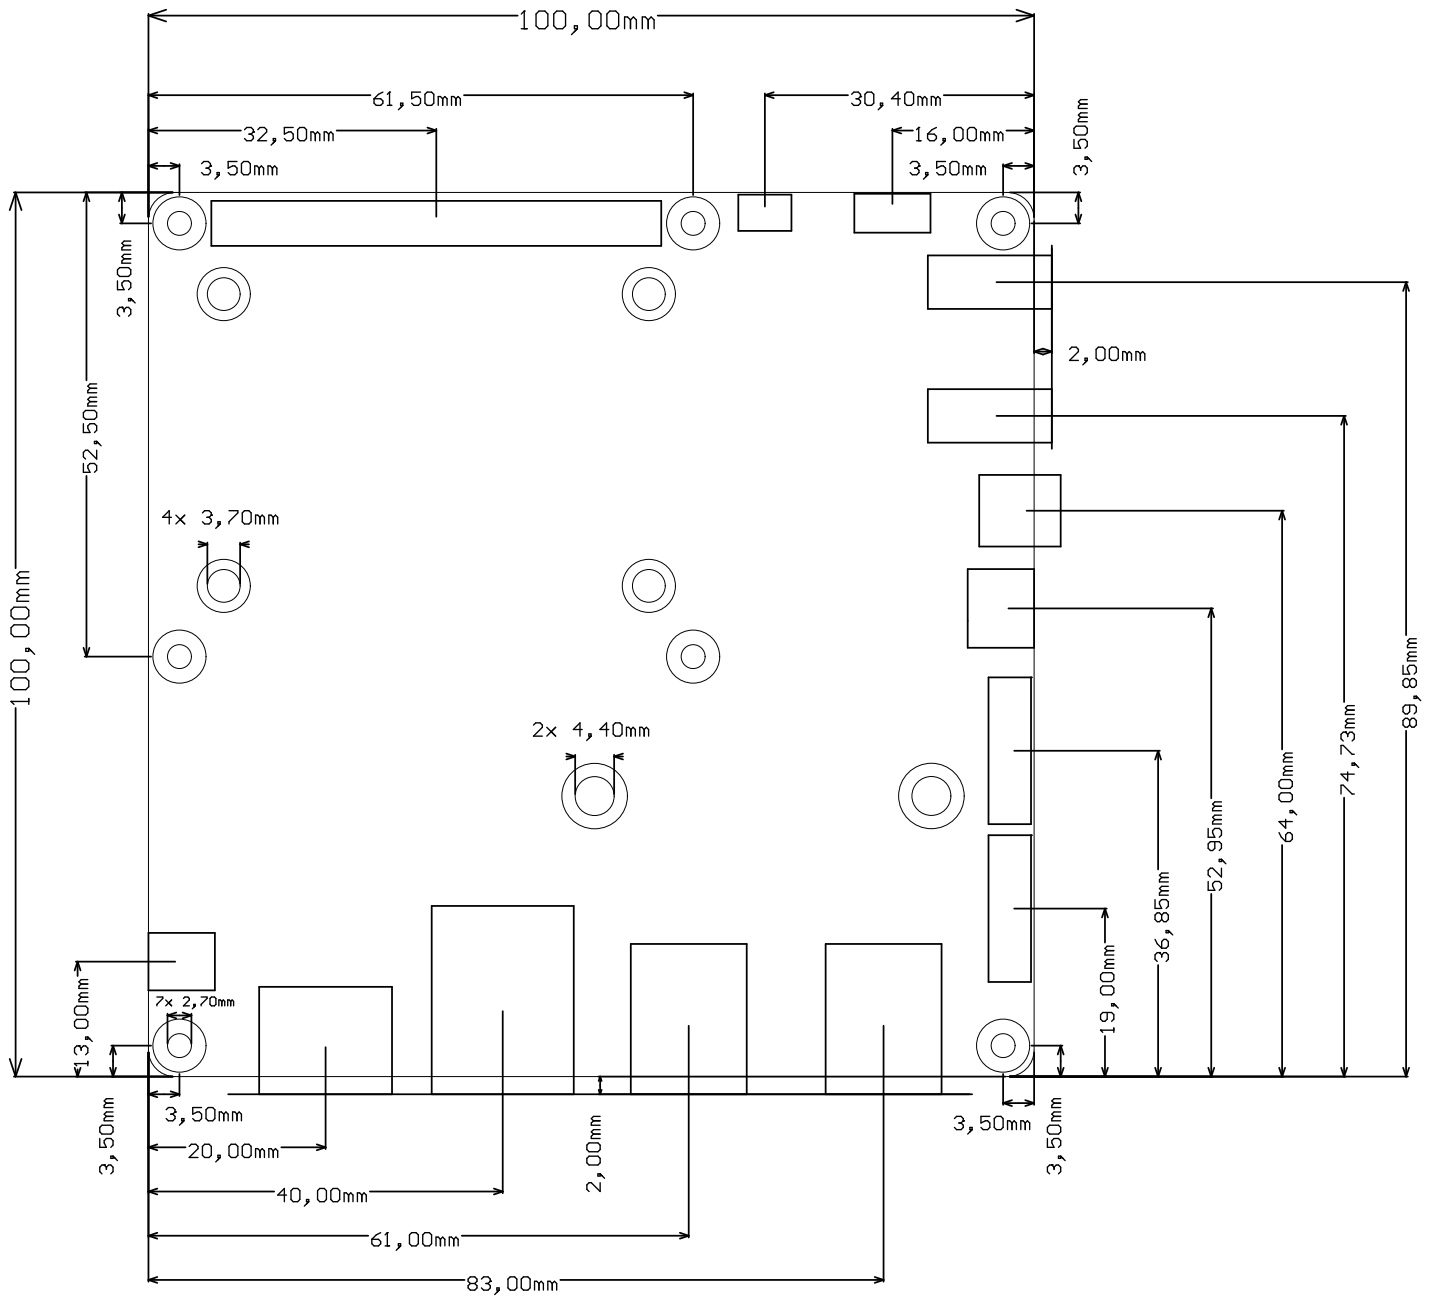
[picture p99: page 2]
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
