mfolejewski/MirkoPC/MirkoPC_block_schematic_draft_2021-03-24.pdf

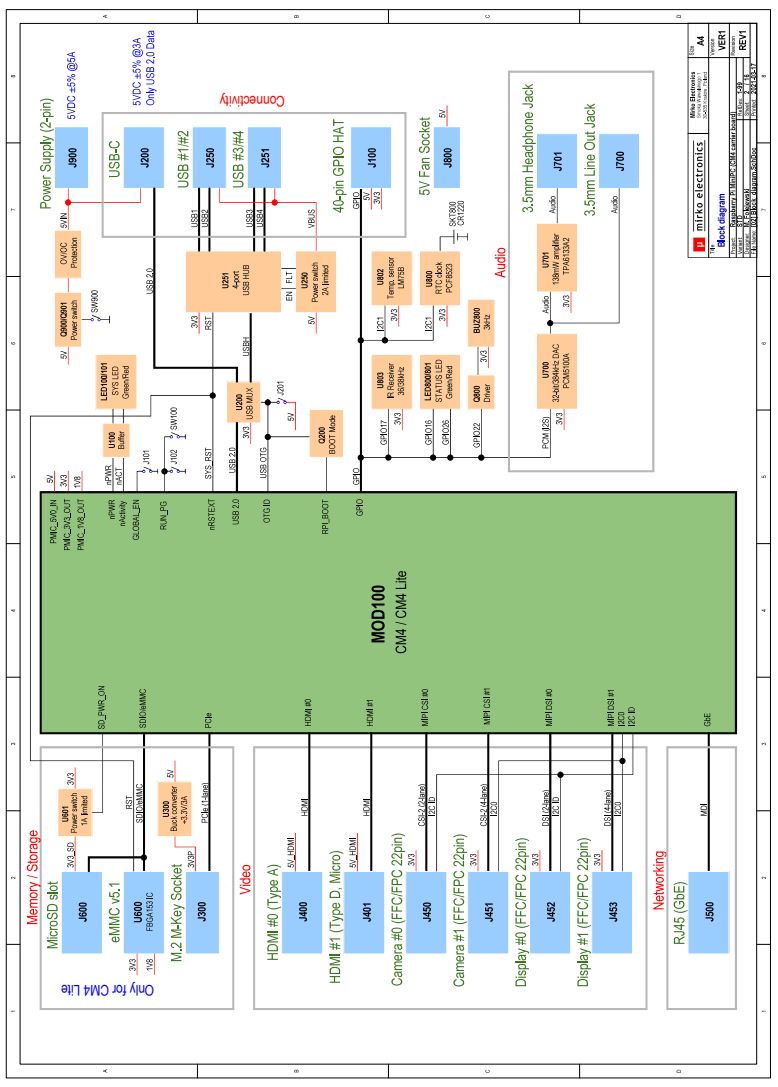
[picture p100: page 1]
Connectivity

Only for CM4 Lite
