mfolejewski/MirkoPC/MirkoPC_V1_dimensions_2021-03-16.pdf

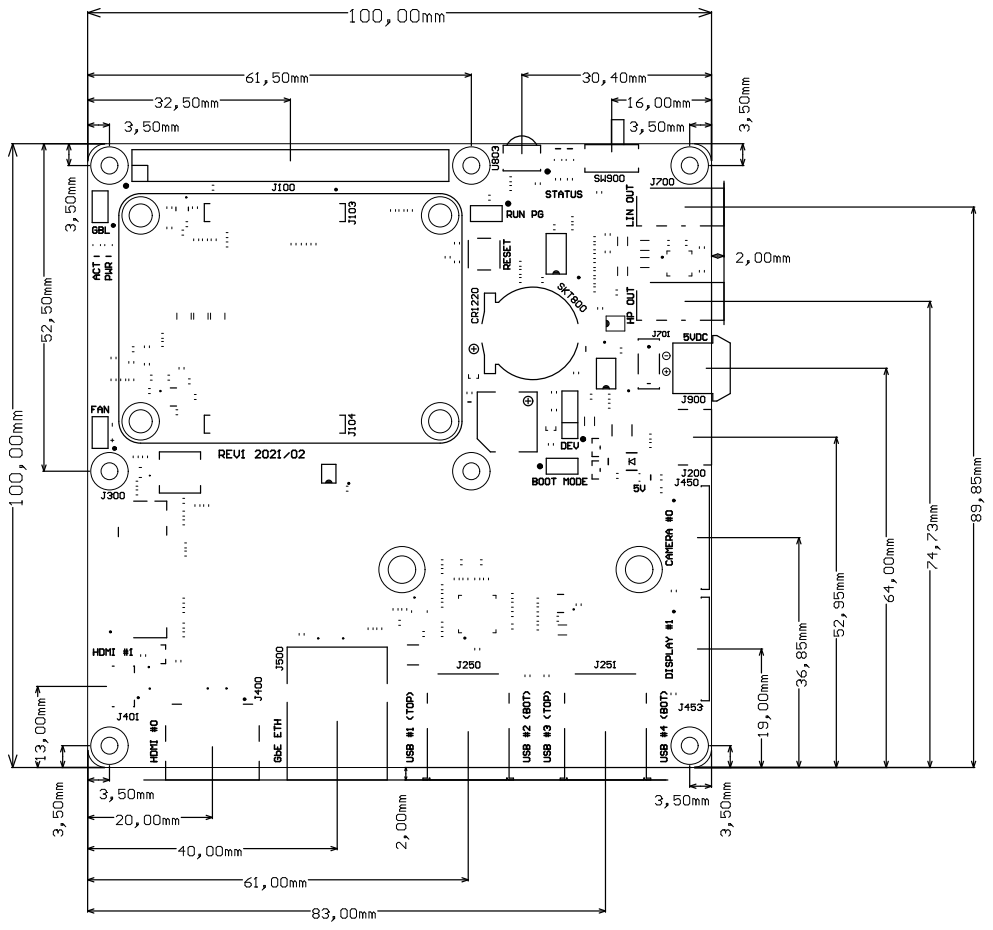
[picture p101: page 1]
