mfolejewski/MirkoPC/(commit log)

2021-03-16 Add files via upload
    MirkoPC - mechanical dimensions (DXF format)
    [MirkoPC_V1_dimensions_2021-03-16.dxf]
2021-03-17 Add files via upload
    MirkoPC - 3D PCB board visualization (PDF file compressed)
2021-03-24 MirkoPC -> block schematic (system architecture)
    DRAFT, 2021-03-24
2021-04-10 MirkoPC Assembly THT + SMD
2021-05-07 Add files via upload
    MirkoPC REV1 full schematics (PDF) format
2021-07-04 Add files via upload
    PDF Schematic for MirkoPC R1.1
